dlavila/puc_thesis/lascas/Digital assistance for energy reduction in analogue-to-digital converters using a signal prediction algorithm/bib.bib.tex

@ARTICLE{1624325, 
author={Murmann, B.}, 
journal={Micro, IEEE}, title={Digitally Assisted Analog Circuits}, 
year={2006}, 
volume={26}, 
number={2}, 
pages={38-47}, 
keywords={analogue circuits;analogue-digital conversion;digital-analogue conversion;mixed analogue-digital integrated circuits;analog circuit;analog signal;analog-to-digital converter;digital circuit;digital-to-analog converter;power efficiency;Analog circuits;Analog computers;Broadband antennas;CMOS technology;Computer interfaces;Low-noise amplifiers;Power dissipation;Radio frequency;Sampling methods;Throughput;analog circuits;analog signals;analog-to-digital converter;digital computing}, 
doi={10.1109/MM.2006.33}, 
ISSN={0272-1732},}
