dlavila/puc_thesis/thesis/Chacarero/chacarero.pptx

## Discrete-time noise filtering for Pulse-Processing in particle physics experiments

Diego Ávila

This work was supported by the National Commission for Scientific and Technological Research (CONICYT) of Chile under grant FONDECYT 11110165 and scholarship CONICYT-PCHA/Magíster Nacional/2013 - folio 221320673.

## Outline

1. Motivations
2. Basic concepts: noise analysis for pulse-processing in particle physics experiments
3. Noise analysis in pulse-processing discrete-time filters
4. A SC filter for arbitrary weighting function synthesis (if we have time)
5. Conclusion

## Motivations

- The ILC

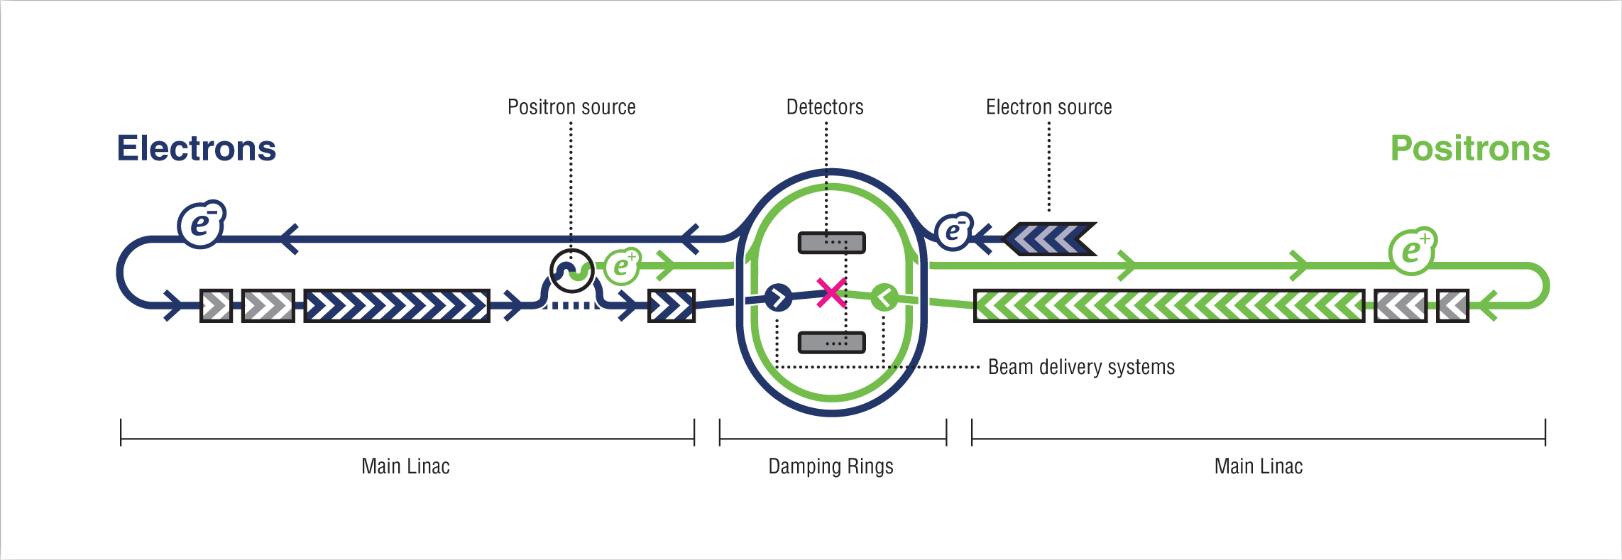
[picture p1: figure]

## Slide 4

- The Bean

## Basic concepts: noise analysis for pulse-processing in particle physics experiments

- As electrical engineers we are used to model the noise in the frequency domain.
- Most of the times we deal with continuous processes: we assume that the noise process started at - ∞ (stationary noise process).

## Slide 6

… but in pulse-processing for particle physics

Start after restarting CF

Finite-time process

End after taking the sample

A continuous-time noise analysis is more intuitive

## Weighting function

- White noise can be modeled as a Poisson sequence of Dirac impulses.
- Colored noise can be modeled as a Poisson sequence of shaped pulses.

## Slide 8

animation

## Slide 9

Our approach

[Avila, Alvarez, Abusleme, IEEE TNS 2013]

## Slide 10

## Slide 11

## Slide 12

## Slide 13

## Slide 14

Result

Low entropy expression: input noise can be easily identified and separate from filter influence

## Slide 15

Comparison (thermal noise)

Weighting function

Our approach

## SNR maximization

- In the following configuration

Where

## Slide 17

we want to minimize

Independent variables

## Slide 18

Results:

## Slide 19

## Slide 20

## A SC filter for arbitrary weighting function synthesis

- UMC180nm (through Europractice)
- Mentor graphics tools (ICUC new analog toolchain)

## Slide 22

## Slide 23

## Slide 24

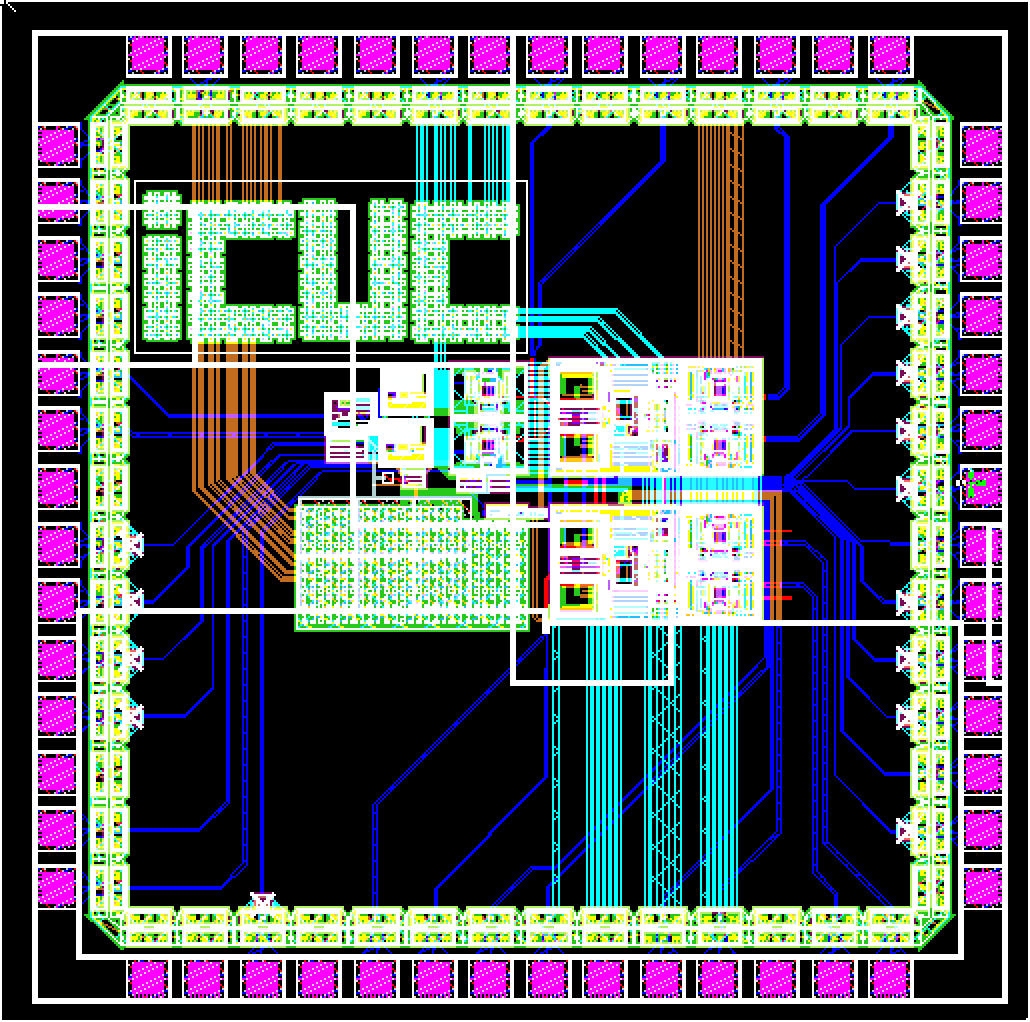
[picture p2: figure]
Screen Shot 2014-04-20 at 8.01.14 PM.pdf

~1.5 mm x 1.5mm

## Slide 25

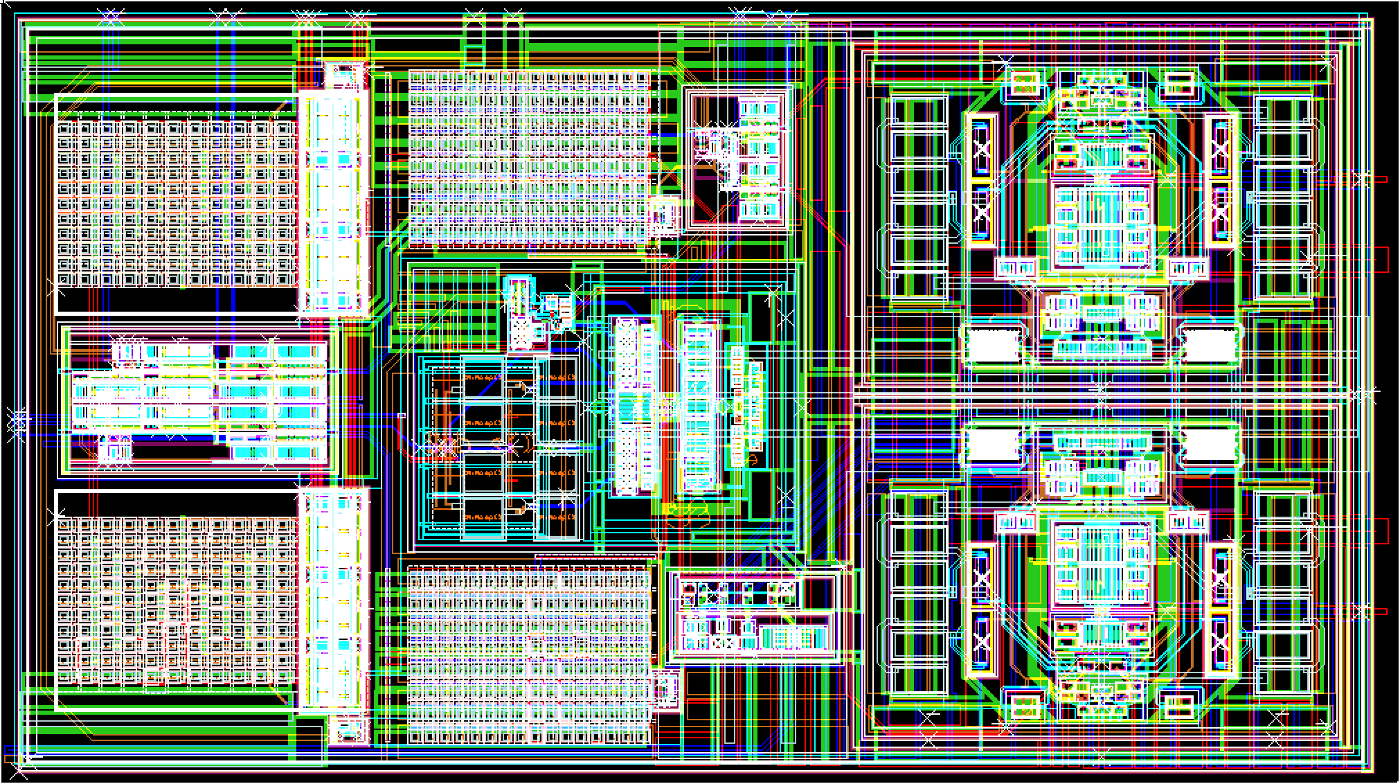
[picture p3: figure]
filter_layout.pdf

Cs Cf OTA Buffers Logic

~ 185um x 332um

## Slide 26

Post-layout simulations

Filter step response (64 available gains)

Due to the binary cap arrangement

## Slide 27

## Slide 28

Conclusion

## Slide 29

Thank you
