dlavila/puc_thesis/Presentation1.pptx

## Discrete-time noise filtering for Pulse-Processing in particle physics experiments

Diego Ávila

This work was supported by the National Commission for Scientific and Technological Research (CONICYT) of Chile under grant FONDECYT 11110165 and scholarship CONICYT-PCHA/Magíster Nacional/2013 - folio 221320673.

## Outline

1. Motivations
2. Basic concepts: noise analysis for pulse-processing in particle physics experiments
3. Noise analysis in pulse-processing discrete-time filters
4. A SC filter for arbitrary weighting function synthesis (if we have time)
5. Conclusion

## Motivations

- The ILC
- The Bean

## Basic concepts: noise analysis for pulse-processing in particle physics experiments

- As electrical engineers we are used to model the noise in the frequency domain.
- Most of the times we deal with continuous processes: we assume that the noise process started at - ∞ (stationary noise process).

## Slide 5

… but in pulse-processing for particle physics

Start after restarting CF

Finite-time process

End after taking the sample

A continuous-time noise analysis is more intuitive

## Weighting function

- White noise can be modeled as a Poisson sequence of Dirac impulses.
FALTA COMPLETAR

## Slide 7

Our approach

## Slide 8

## Slide 9

## Slide 10

## Slide 11

## Slide 12

Result

Low entropy expression: input noise can be easily identified and separate from filter influence

## SNR maximization

- In the following configuration

Where

## Slide 14

we want to minimize

Independent variables

## Slide 15

Results:

## Slide 16

## Slide 17

## A SC filter for arbitrary weighting function synthesis

- UMC180nm (through Europractice)
- Mentor graphics tools (ICUC new analog toolchain)

## Slide 19

Screen Shot 2014-04-20 at 8.01.14 PM.pdf

~1.5 mm x 1.5mm

## Slide 20

filter_layout.pdf

Cs Cf OTA Buffers Logic

~ 185um x 332um

## Slide 21

Post-layout simulations

Filter step response (64 available gains)

Due to the binary cap arrangement

## Slide 22

FALTA LA FIGURA DEL STEP RESPONSE CON TIEMPO DE ESTABLECIMIENTO
FALTA LA FIGURA EN QUE SE VERIFICAN HOLD, RST, SGN
