dlavila/puc_thesis/thesis/figures/thebean_diag-eps-converted-to.pdf

# The Bean Prototype

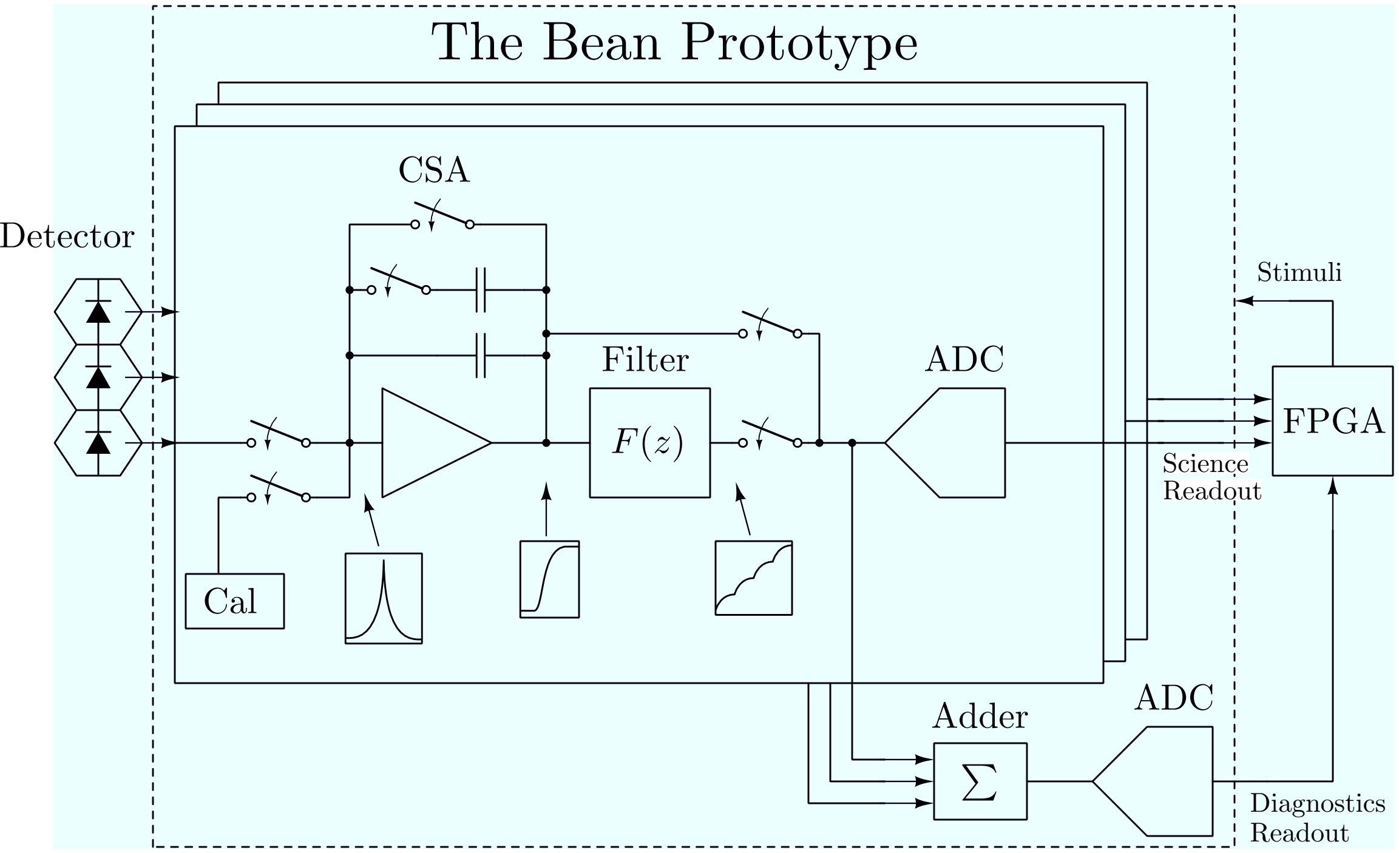
[picture p4: page 1]

Detector

CSA

Filter | ADC

ADC Adder

FPGA

!

F(z)

Cal

Diagnostics
Readout

Stimuli

Science
Readout
