dlavila/puc_thesis/thesis/figures/noise_cir-eps-converted-to.pdf

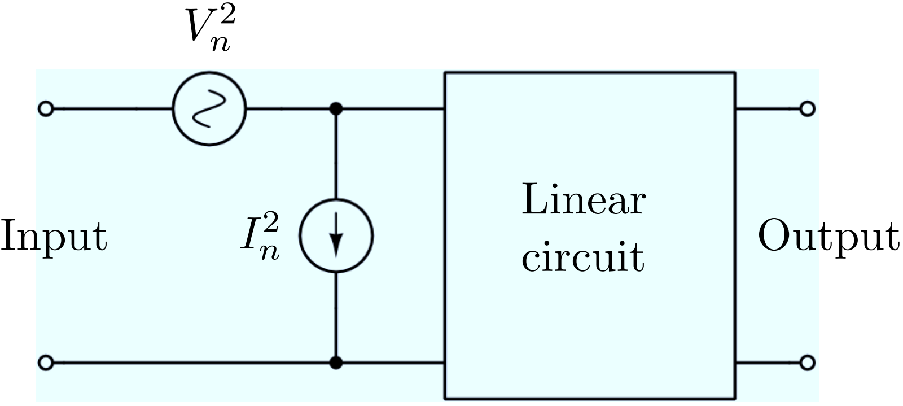
[picture p5: page 1]

Linear

circuit

V

2n

I

2

## Input

n | Output
