dlavila/puc_thesis/thesis/figures/filter_layout.pdf

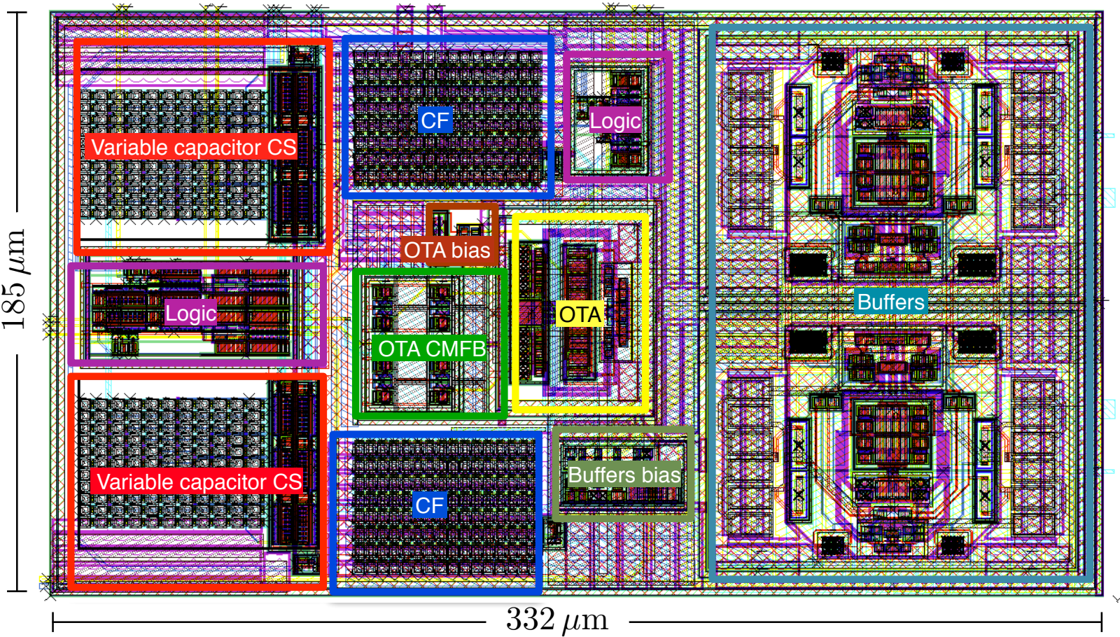
[picture p6: page 1]

332 µm

185

µ

m

OTA CMFB

OTA

CF

CF

Variable capacitor CS

Variable capacitor CS

Buffers Logic

OTA bias

Logic

Buffers bias
