dlavila/puc_thesis/thesis/figures/IC_layout.pdf

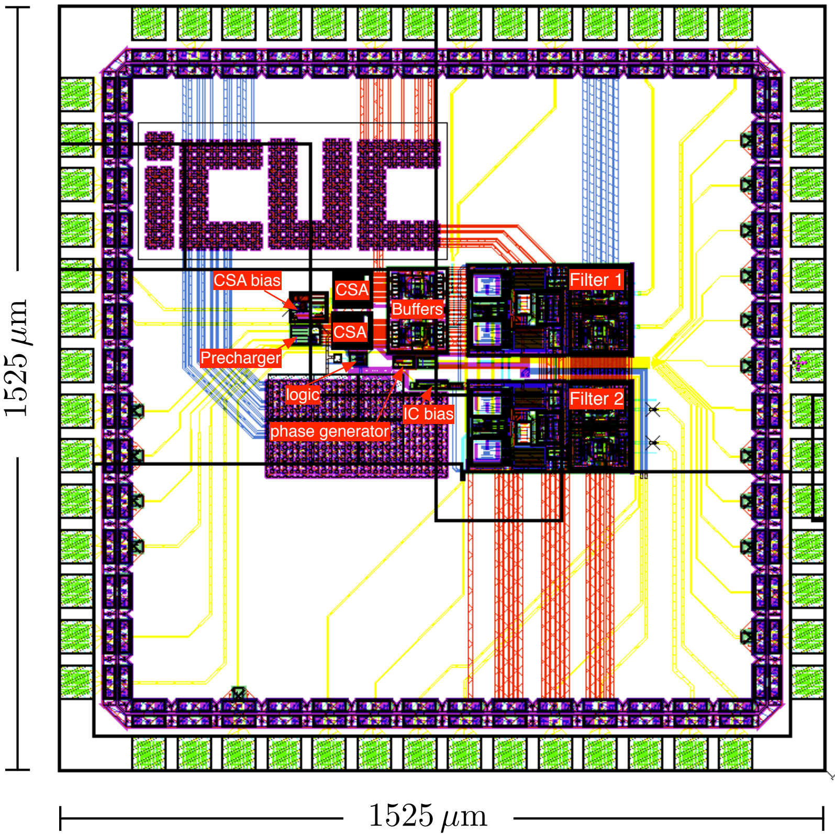
[picture p7: page 1]

1525 µm

1525

µ

m

Filter 1

Filter 2

Buffers
CSA

CSA

IC bias

Precharger

phase generator

CSA bias

logic
