dlavila/puc_thesis/thesis/figures/Filter/bias_filter_post-eps-converted-to.pdf

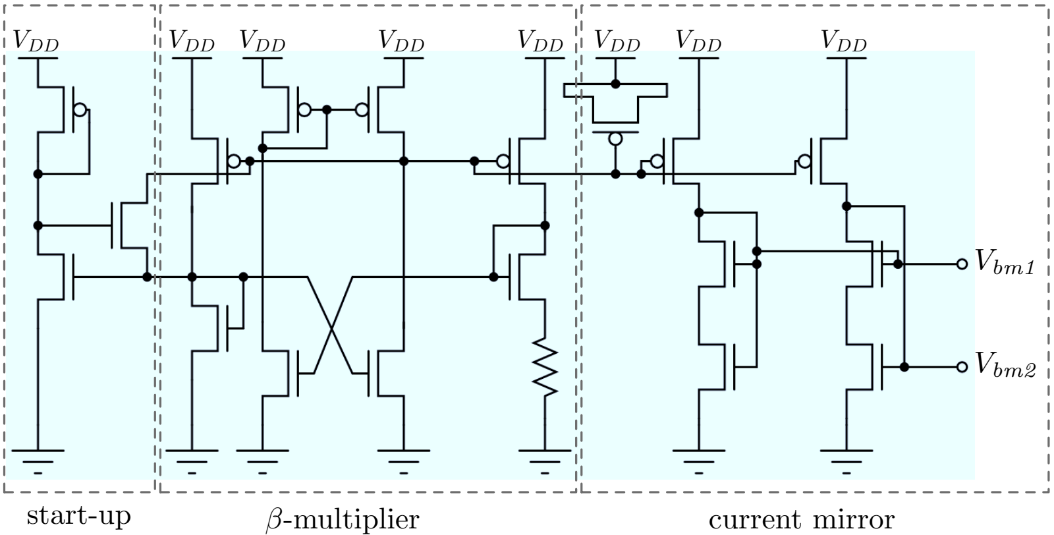
[picture p8: page 1]

VDD | VDD | VDD | VDD | VDD | VDD | VDD | VDD

Vbm1

Vbm2

start-up | β-multiplier | current mirror
