dlavila/puc_thesis/thesis/figures/bondpad.pdf

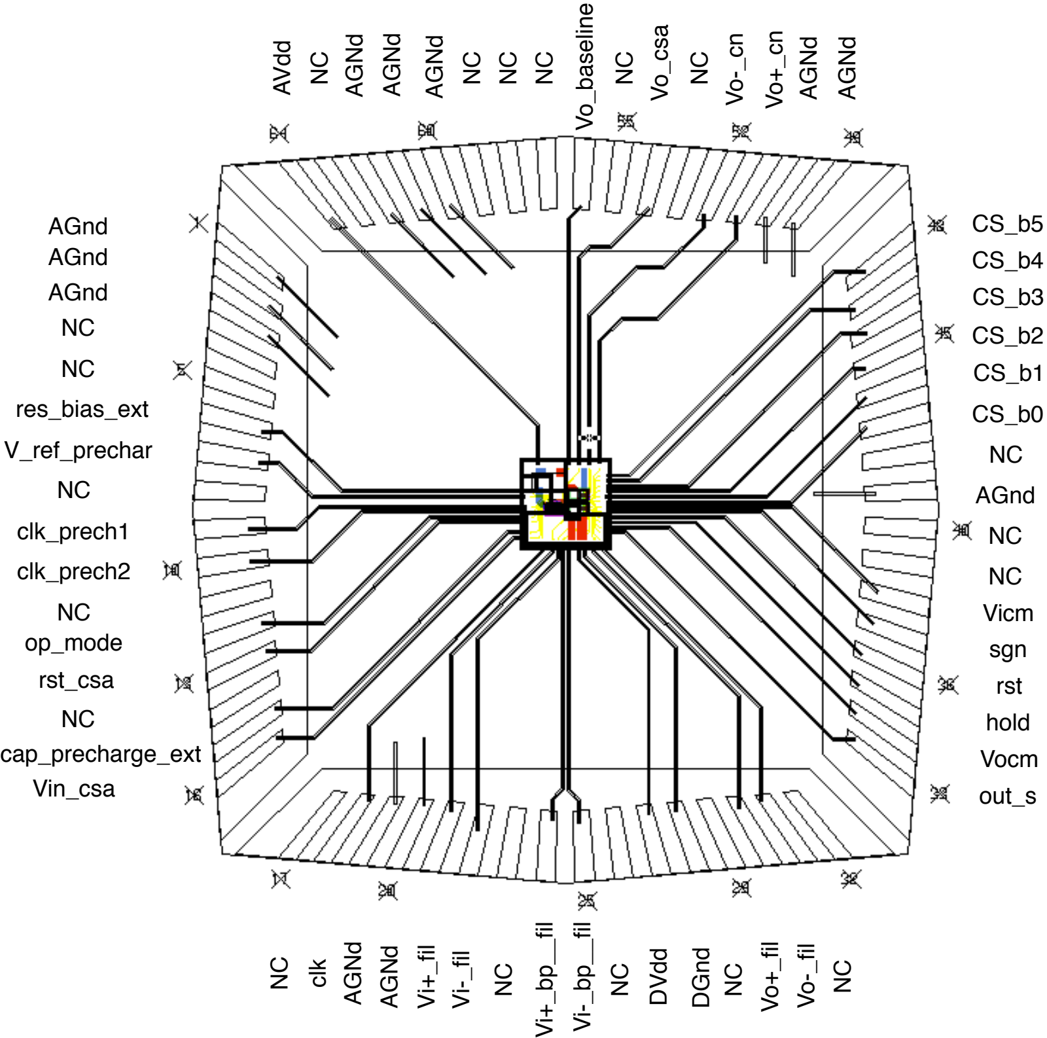
[picture p9: page 1]

AGnd
AGnd
AGnd
NC
NC
res_bias_ext

NC

clk_prech1
clk_prech2

NC
op_mode
rst_csa
NC
cap_precharge_ext
Vin_csa

V_ref_prechar

NC
clk

AGNd
AGNd

Vi+_fil
Vi-_fil
NC

Vi+_bp__fil
Vi-_bp__fil

NC

DVdd

DGnd
NC

Vo+_fil
Vo-_fil
NC

out_s

Vocm

hold

rst

sgn

Vicm

NC

NC

AGnd

NC

CS_b0

CS_b1

CS_b2

CS_b3

CS_b4

CS_b5

NC

NC

NC

NC

NC

NC

AGNd

AGNd

Vo_csa
Vo-_cn

Vo+_cn

Vo_baseline
AVdd

AGNd

AGNd
AGNd
