dlavila/puc_thesis/thesis/figures/buffer_layout-eps-converted-to.pdf

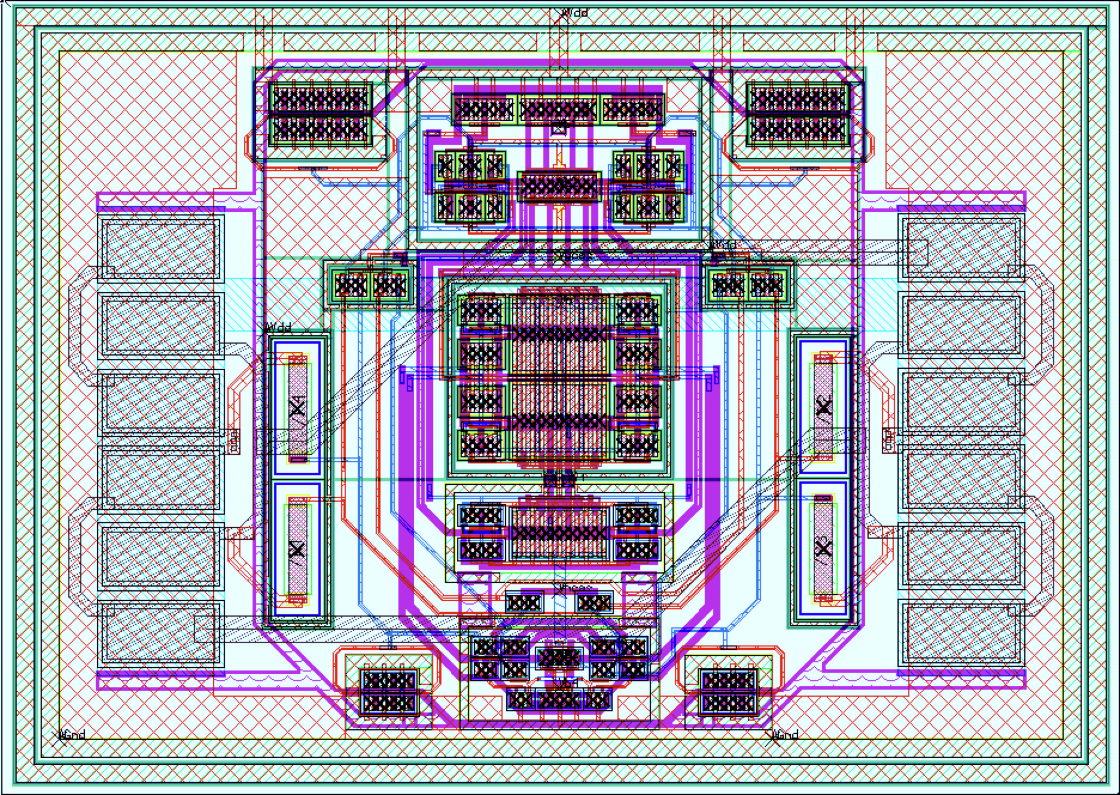
[picture p10: page 1]
