dlavila/puc_thesis/thesis/figures/CSA_layout-eps-converted-to.pdf

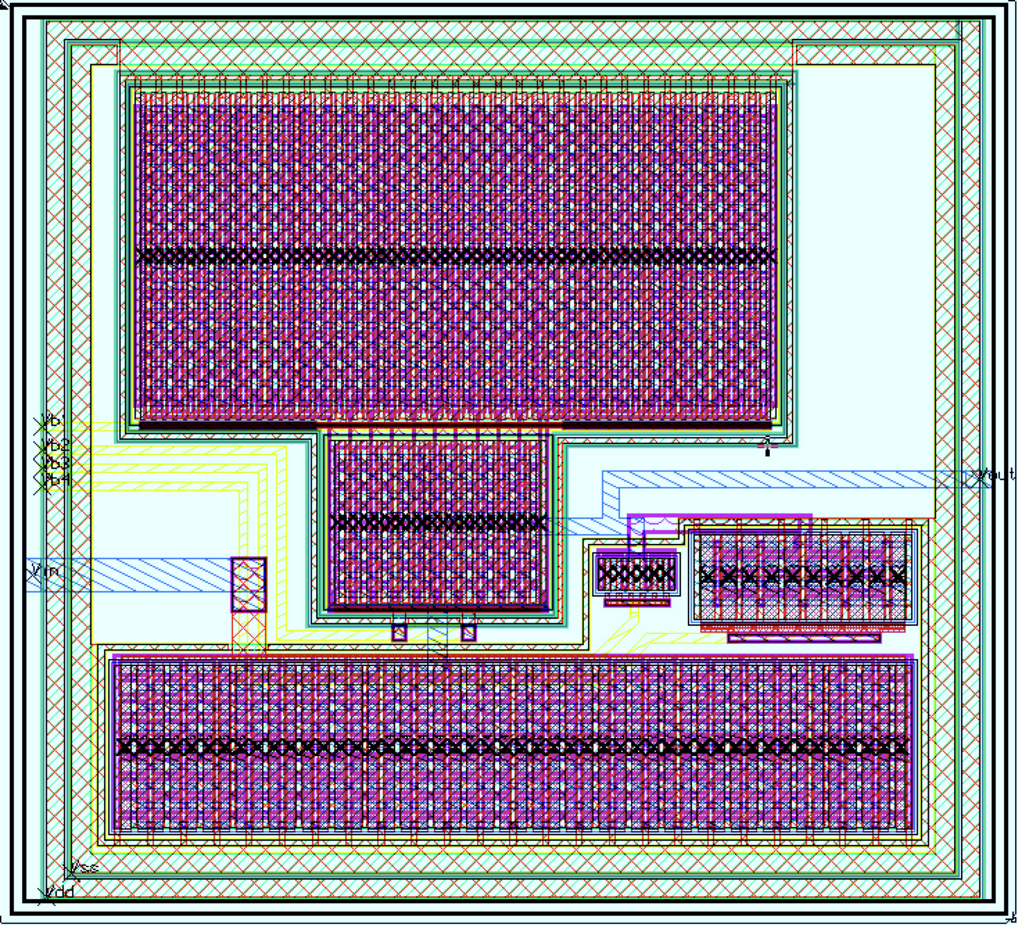
[picture p11: page 1]
