dlavila/puc_thesis/thesis/figures/csa_post-eps-converted-to.pdf

C

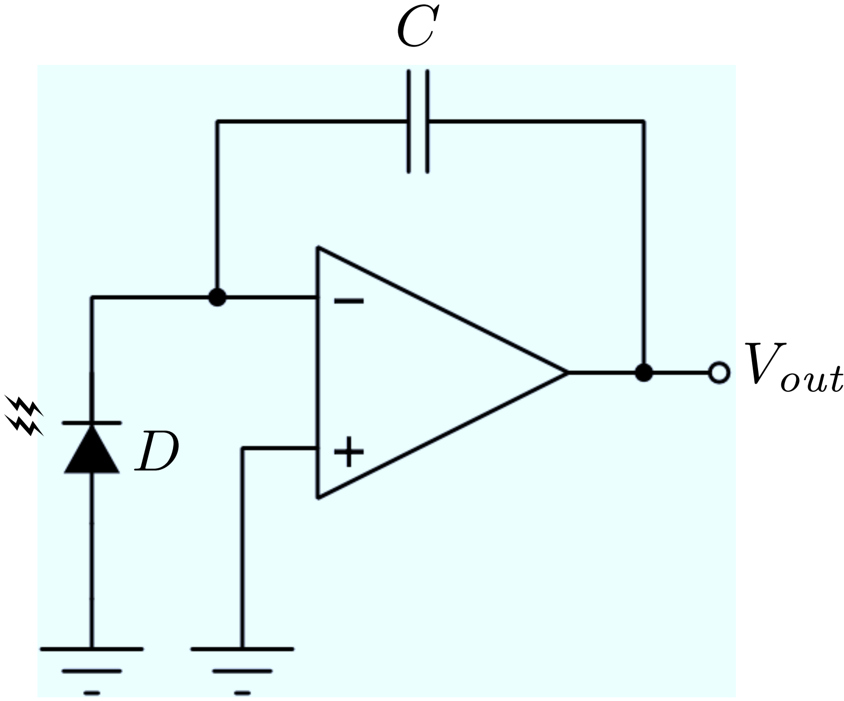
[picture p12: page 1]

D

Vout
