dlavila/puc_thesis/thesis/figures/OTA_layout-eps-converted-to.pdf

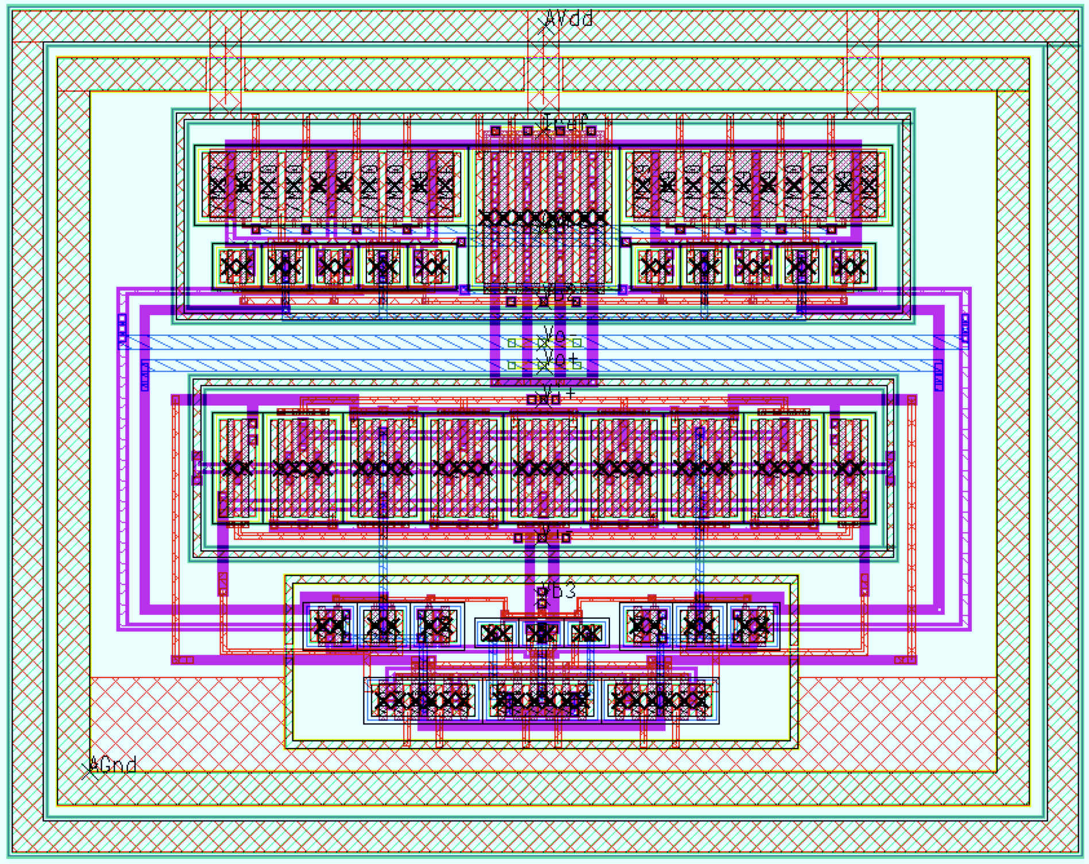
[picture p13: page 1]
