dlavila/puc_thesis/thesis/figures/Untitled.graffle/image1.pdf

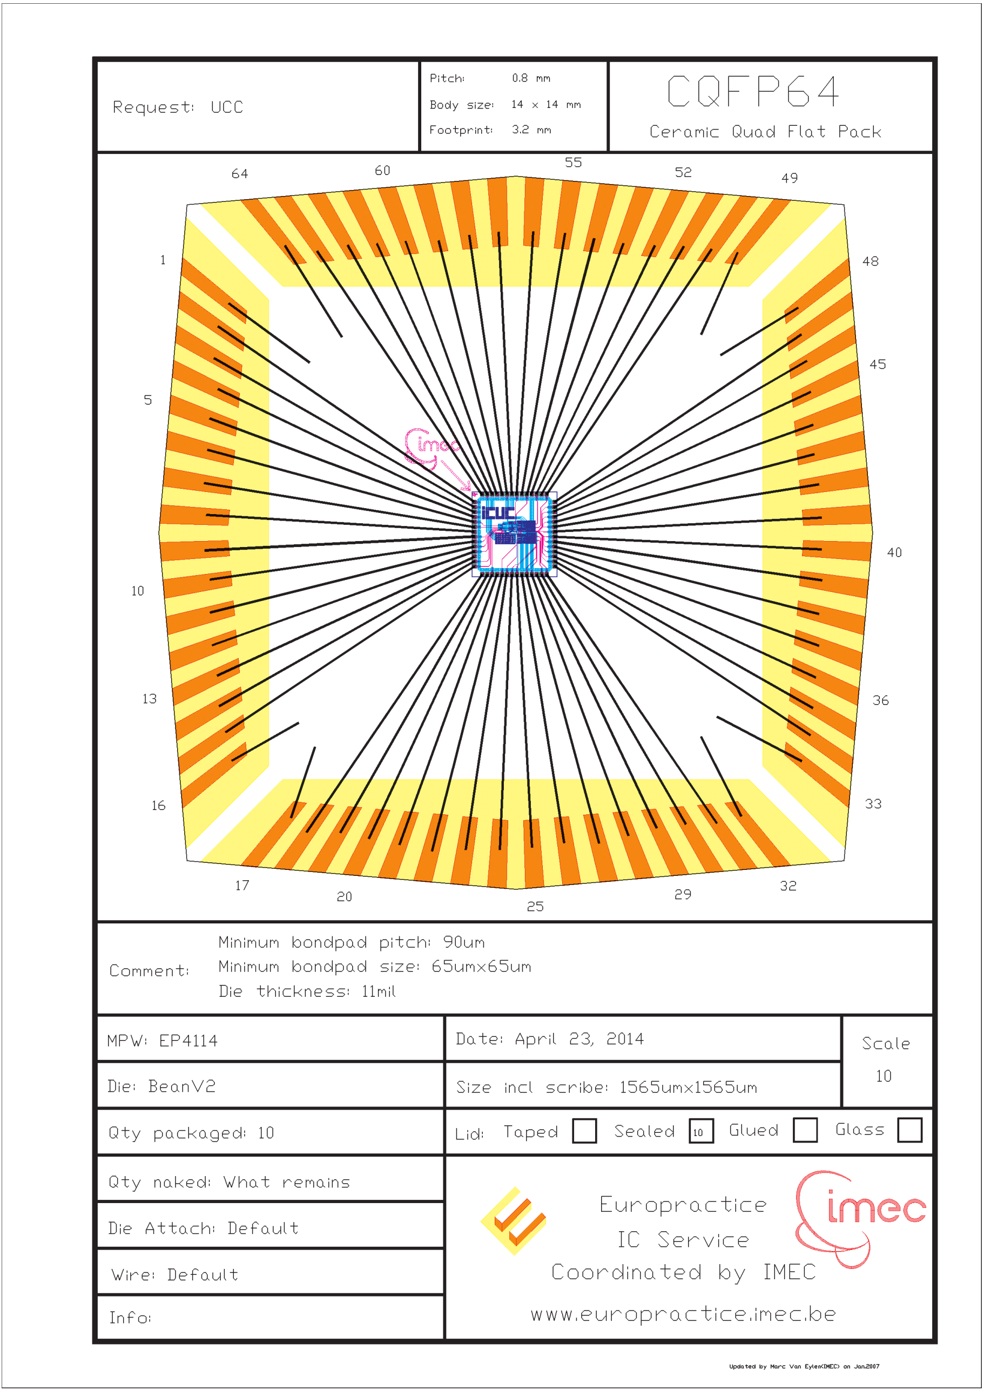
[picture p14: page 1]
