dlavila/puc_thesis/thesis/figures/Filter/bias_all_post-eps-converted-to.pdf

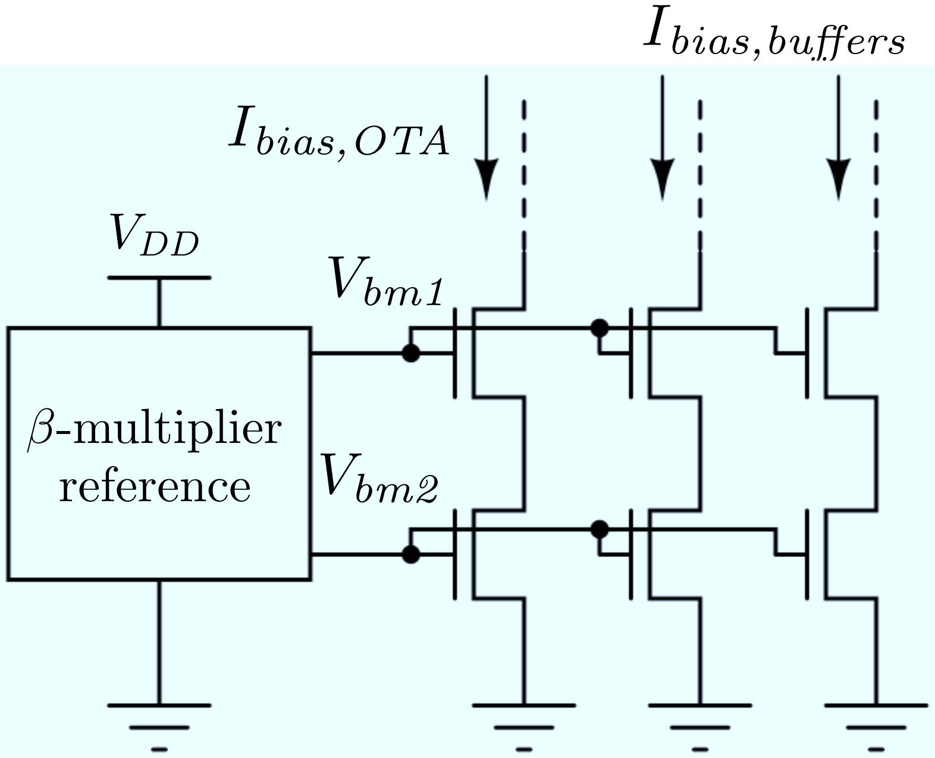
[picture p15: page 1]

VDD

### β-multiplier

reference

Ibias,OTA

Ibias,buffers

Vbm1

Vbm2
