dlavila/puc_thesis/thesis/figures/Filter/bias_buffer_post-eps-converted-to.pdf

Vb1

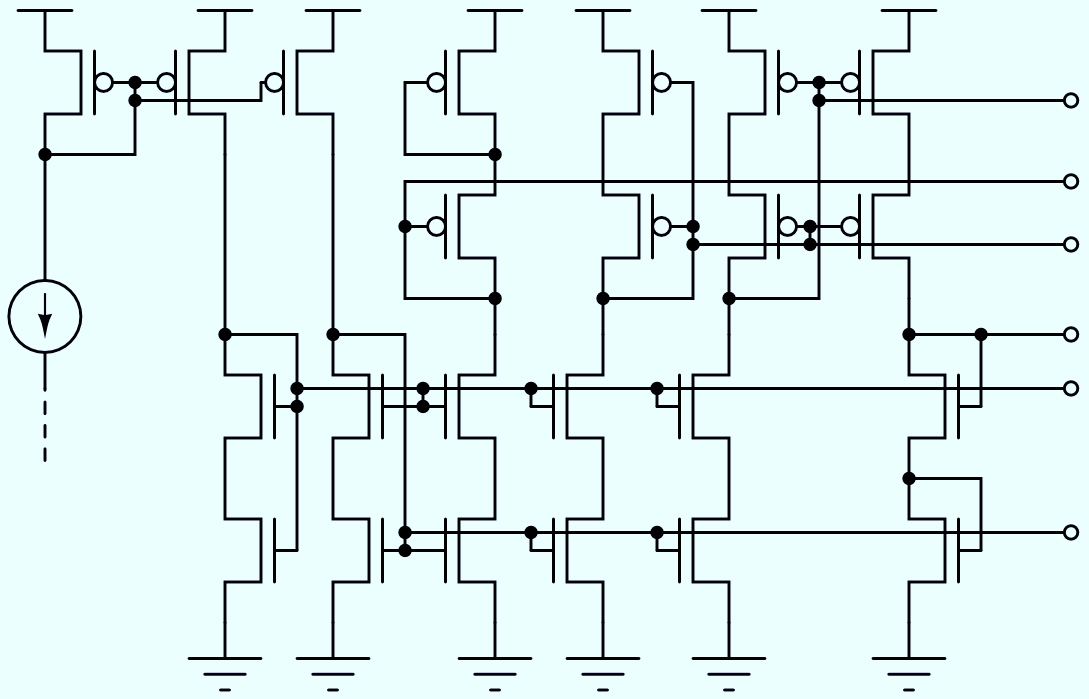
[picture p16: page 1]

VDD | VDD | VDD | VDD | VDD | VDD | VDD

## Ibias,buffer

Vpcas

Vncas

Vb2

Vb3

Vb4
