dlavila/puc_thesis/lascas/Digital assistance for energy reduction in analogue-to-digital converters using a signal prediction algorithm/Figures/graph.png

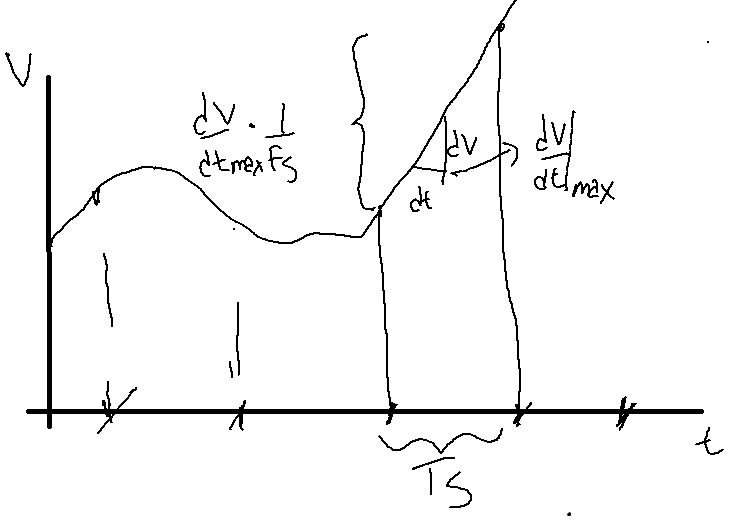
lascas/Digital assistance for energy reduction in analogue-to-digital converters using a signal prediction algorithm/Figures/graph.png
