dlavila/puc_thesis/(list of files, cad)

Other CAD files:
sc_ic/giggity.proj/SC_filter.lib/default.group/layout.views/BUFFER/BUFFER.cal/svdb/template/BUFFER.stl
sc_ic/giggity.proj/SC_filter.lib/default.group/layout.views/BUFFER/BUFFER_2.cal/svdb/template/BUFFER_2.stl
