dlavila/puc_thesis/thesis/Test/test_gains_step_response.csv

.HEADER
..NAMES
Time | V(VO)
..UNITS
s | Voltage(V)
..DATATYPES
double | double
..WAVEFORM_TYPES
 | analog
..AXIS_SPACING
linear
..RUN_FOLDER_INDEX
_1
..FOLDER_NAME
CHANNEL_DesignConfig_test_gains | TRAN
.DATA
5.000000000000001E-8 | 9.227663443860028E-6
5.000125000000001E-8 | 9.16002651162706E-6
5.00023583193436E-8 | 9.082836007867893E-6
5.000457495803077E-8 | 8.91100003973886E-6
5.0008420135110545E-8 | 8.66966003073739E-6
5.001E-8 | 8.650704488284232E-6
5.0011525132285446E-8 | 8.776080441715875E-6
5.001274936410694E-8 | 8.920867765143809E-6
5.0015197827749926E-8 | 9.281286576096154E-6
5.00200947550359E-8 | 1.0274120710818745E-5
5.002983483796483E-8 | 1.2472272408177596E-5
5.003701806581601E-8 | 1.3907320104834784E-5
5.0043845768705344E-8 | 1.49749821532747E-5
5.00533131533761E-8 | 1.5925062258693475E-5
5.006446712603446E-8 | 1.5907476675892455E-5
5.0078742711033945E-8 | 1.3069390876949853E-5
5.010289107645996E-8 | -2.1990954497308337E-6
5.011841843115221E-8 | -2.248029835547154E-5
5.013176936053118E-8 | -5.297205088264788E-5
5.014683145379578E-8 | -1.0064615647388292E-4
5.01610422010588E-8 | -1.4142333546172682E-4
5.0173114820718617E-8 | -1.5727134090557477E-4
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
