dlavila/puc_thesis/thesis/Test/wf_test_circuit-eps-converted-to.pdf

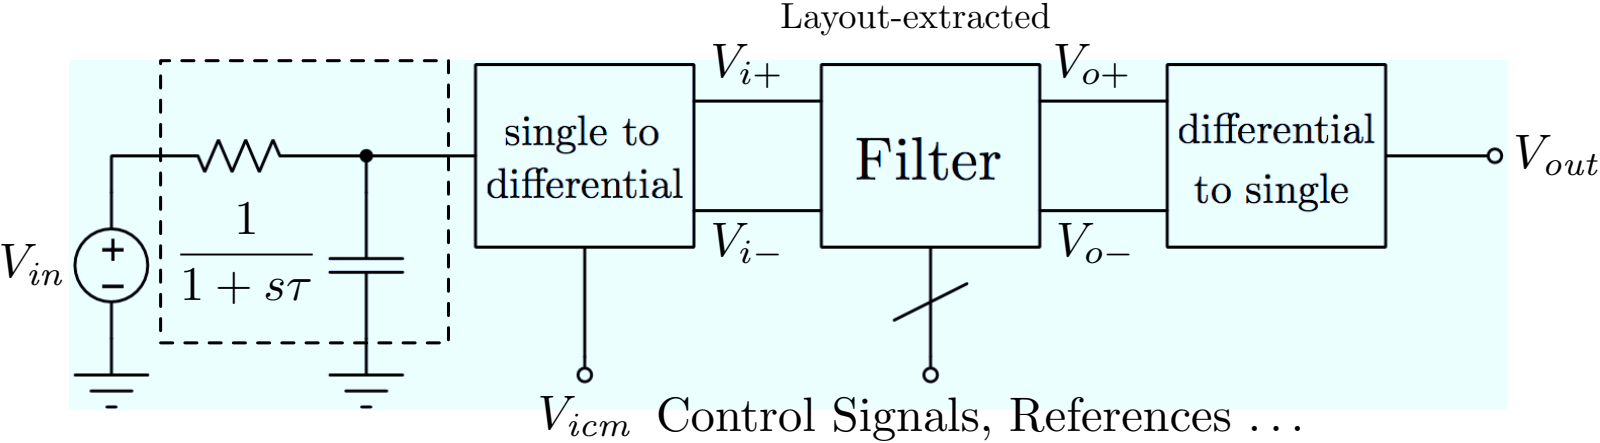
[picture p21: page 1]

Layout-extracted

Filter single to
differential

differential
to single

Vin

Vout

Vicm Control Signals, References . . .

Vi+

Vi− | Vo− Vo+

1

1 + sτ
