dlavila/puc_thesis/thesis/Test/bode_buffer.pdf

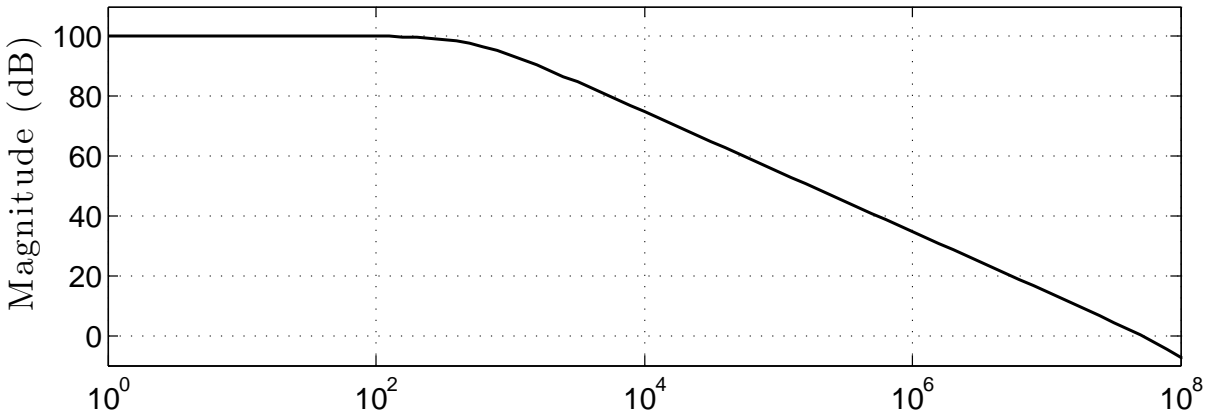
[picture p22: figure]
Magnitude (dB)
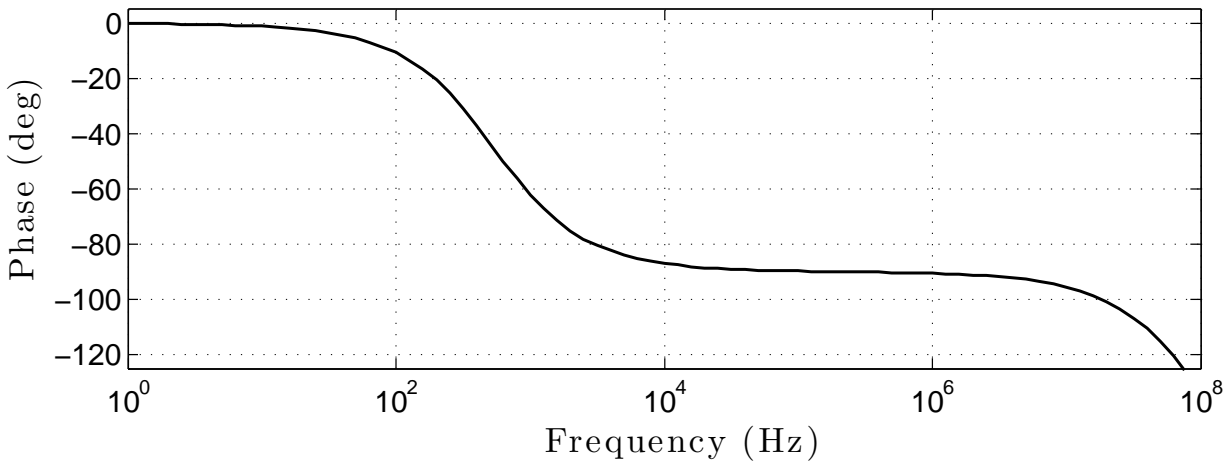
[picture p23: figure]
Phase (de g); Frequency (Hz )
