dlavila/puc_thesis/thesis/Test/bode_OTA.pdf

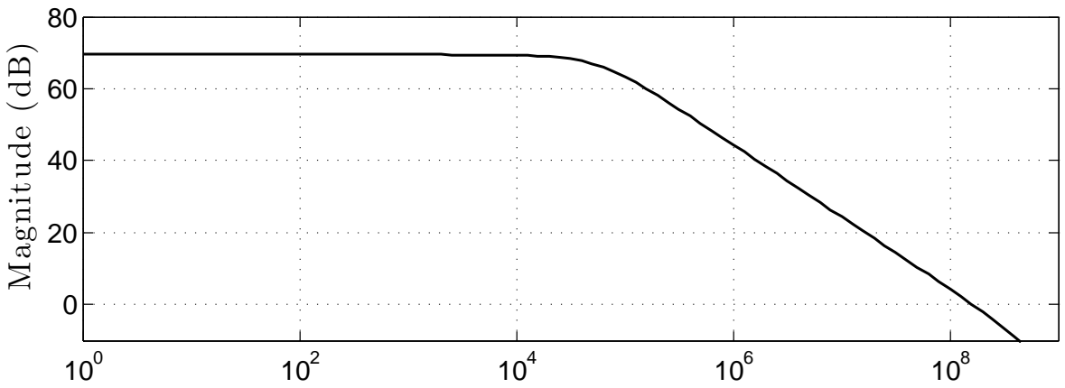
[picture p24: figure]
Magnitude (dB)
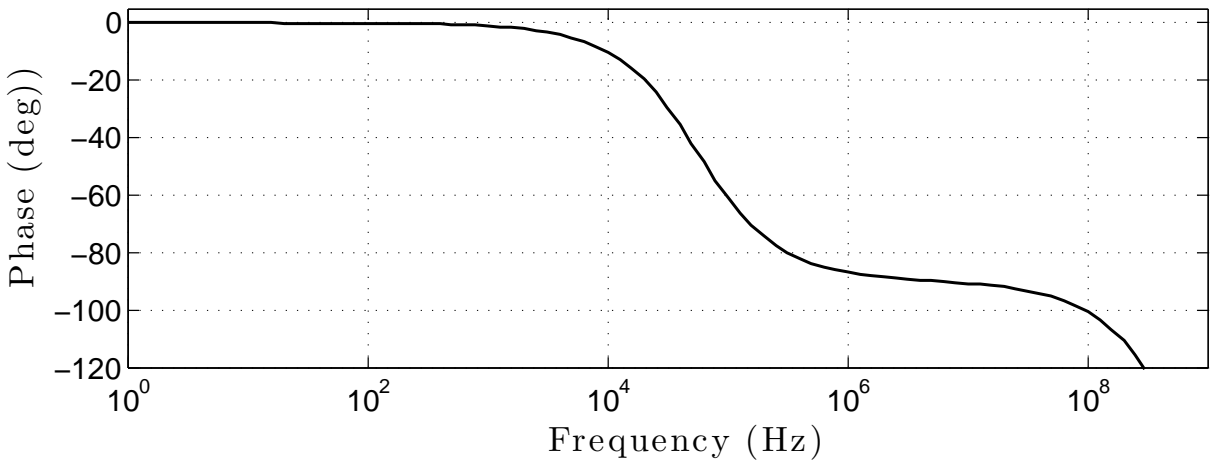
[picture p25: figure]
Phase (de g)); Frequency (Hz )
