dlavila/puc_thesis/thesis/Test/Untitled.graffle/image1.png

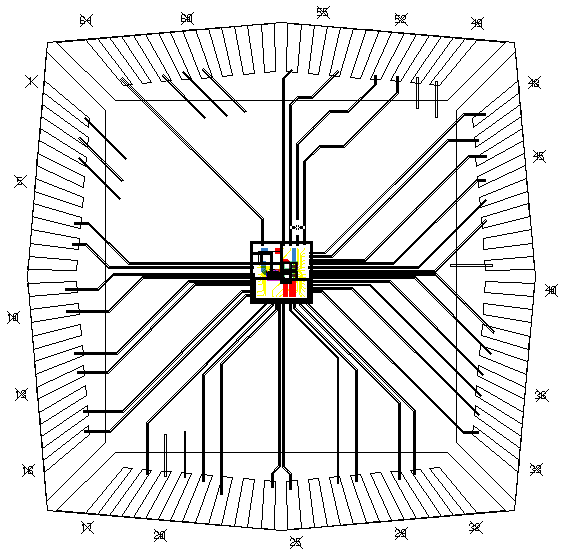
thesis/Test/Untitled.graffle/image1.png
