dlavila/puc_thesis/thesis/Test/Untitled.graffle/image2.png

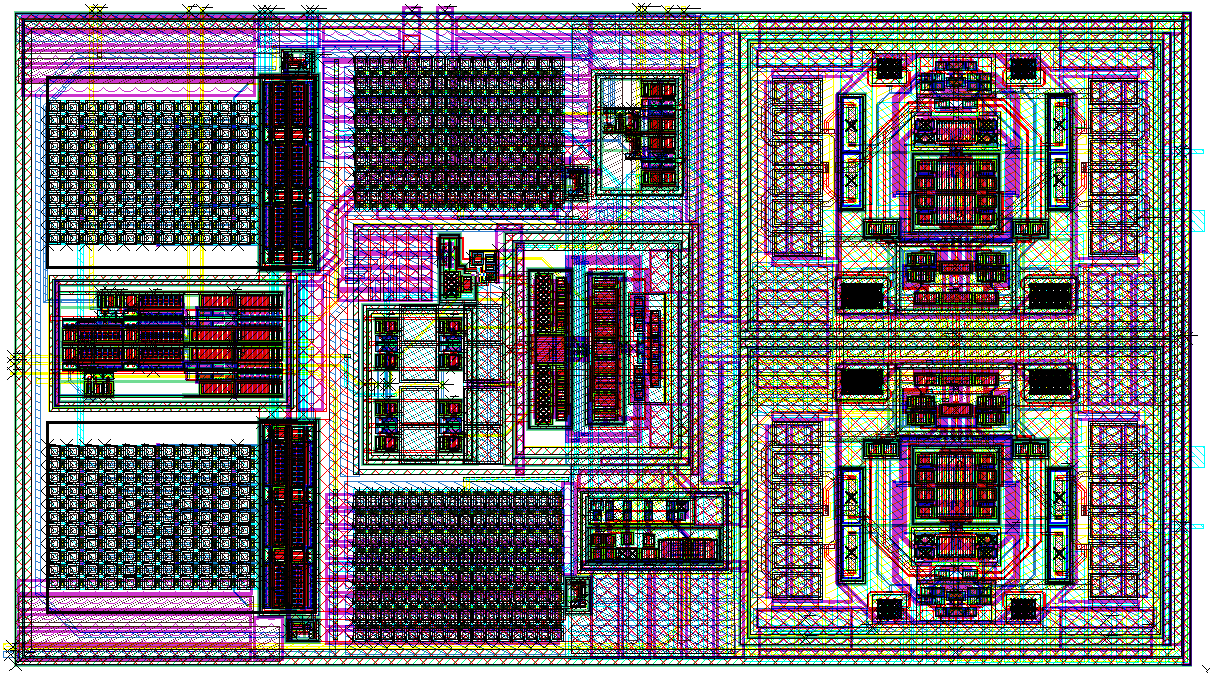
thesis/Test/Untitled.graffle/image2.png
