dlavila/puc_thesis/thesis/Test/Untitled.graffle/image3.png

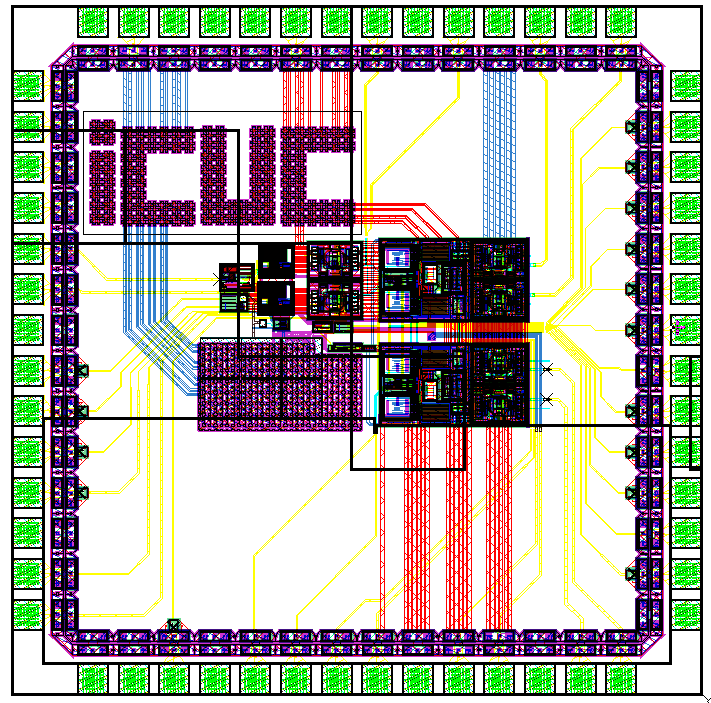
thesis/Test/Untitled.graffle/image3.png
