dlavila/puc_thesis/thesis/Test/bode_buffer_post.pdf

# Frequency (Hz)ADC = 100

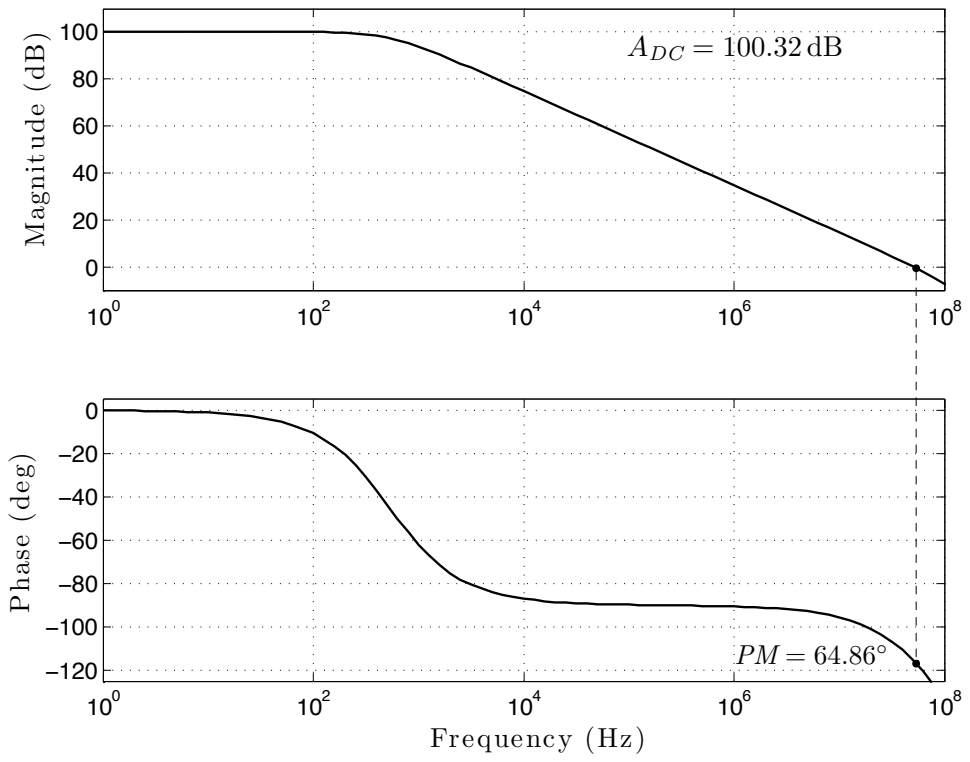
[picture p29: page 1]
Magnitude (dB); Phase (deg)
