dlavila/puc_thesis/thesis/Test/bode_OTA_post-eps-converted-to.pdf

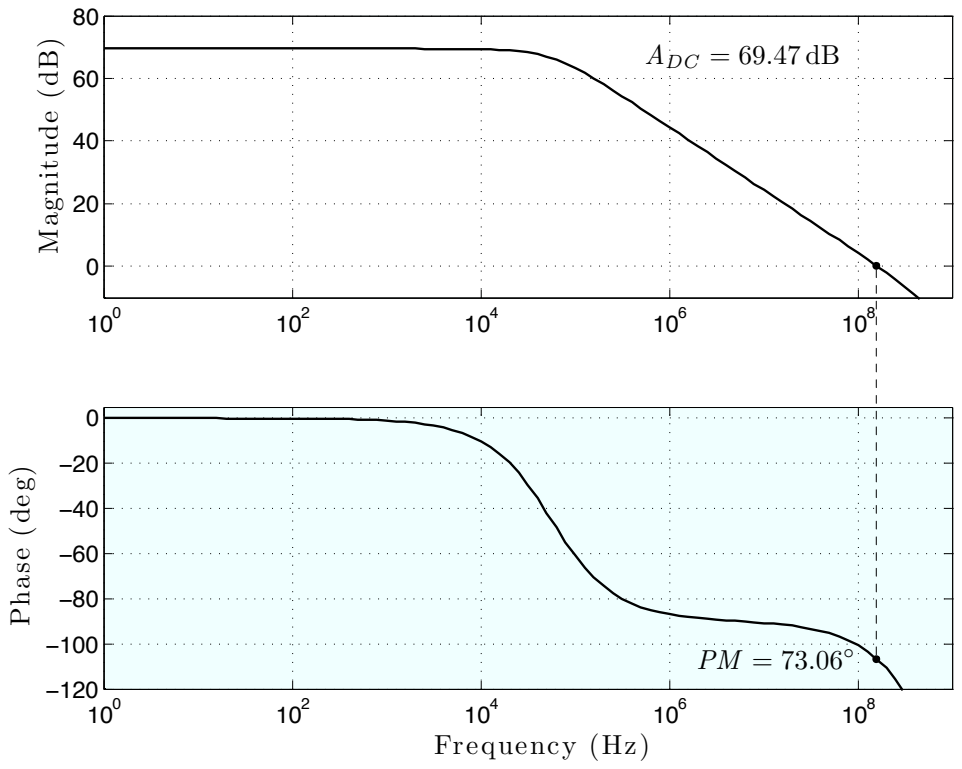
[picture p30: page 1]
Magnitude (dB); Phase (de g)); Frequency (Hz ); ADC = 69 .47 dB
