dlavila/puc_thesis/thesis/Test/gain_curves-eps-converted-to.pdf

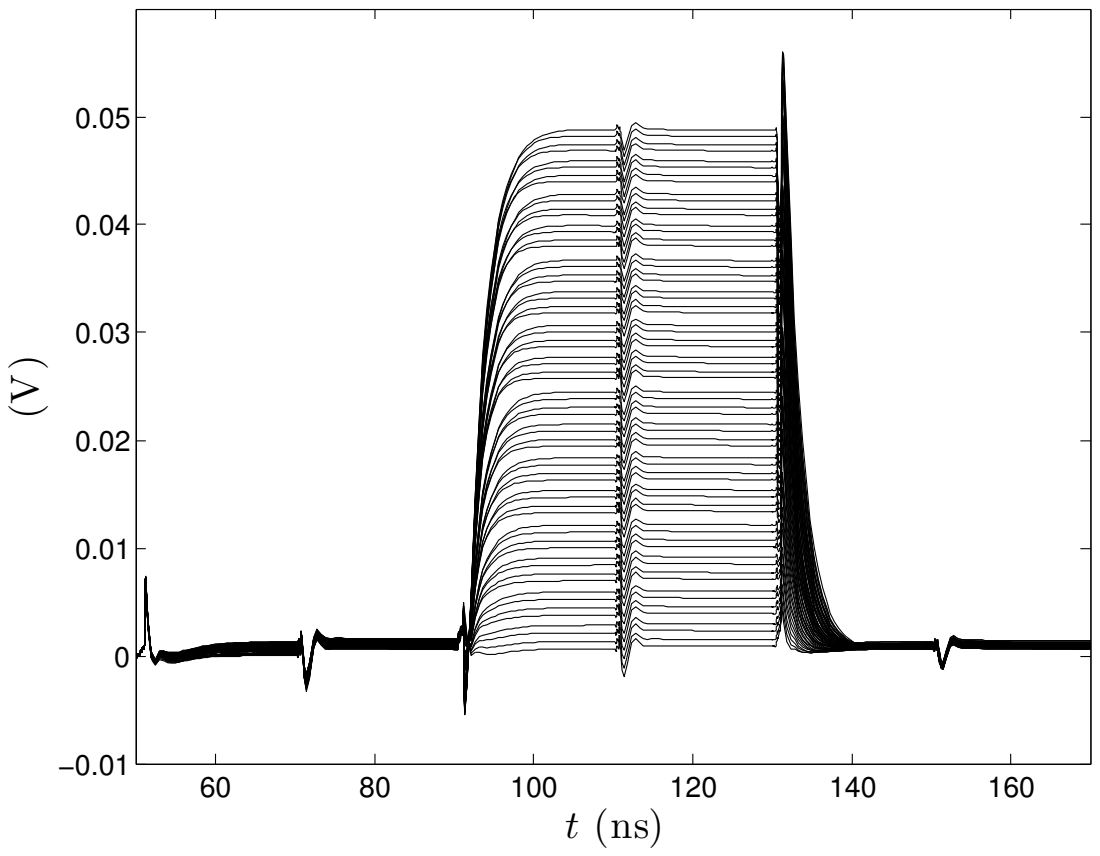
[picture p31: page 1]
