dlavila/puc_thesis/thesis/Test/gain_curves.pdf

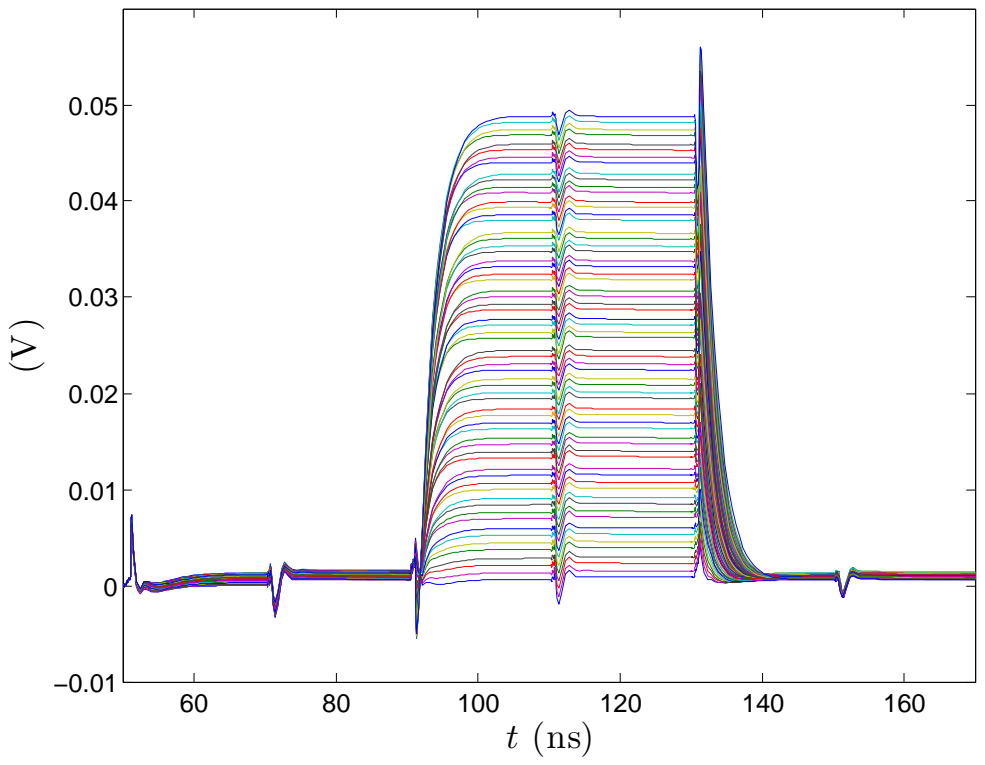
[picture p32: page 1]
