dlavila/puc_thesis/thesis/Test/linearity.pdf

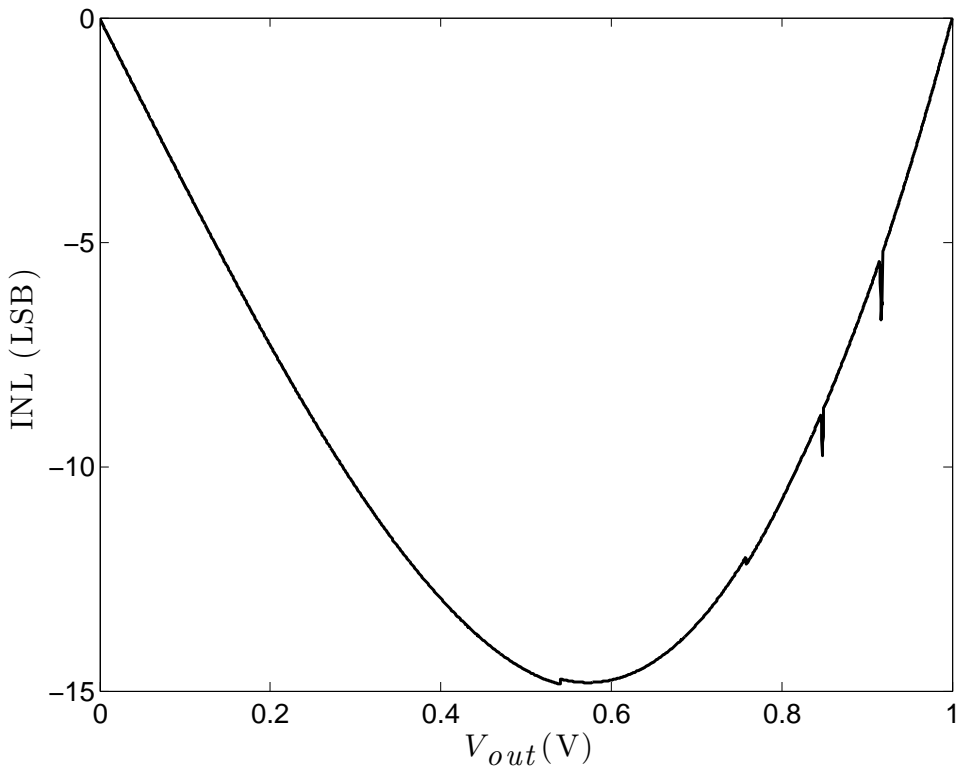
[picture p33: page 1]
INL (LSB ); Vout (V)
