dlavila/puc_thesis/thesis/Test/settling_time.pdf

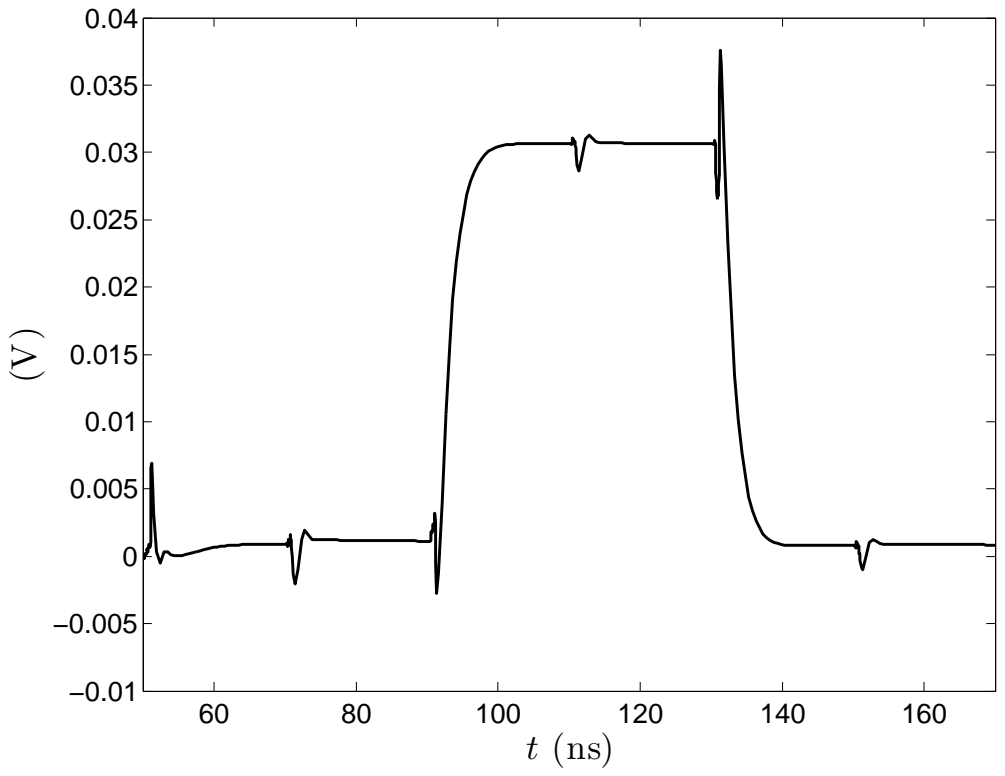
[picture p34: page 1]
