dlavila/puc_thesis/thesis/Test/sim_wf-eps-converted-to.pdf

0.81

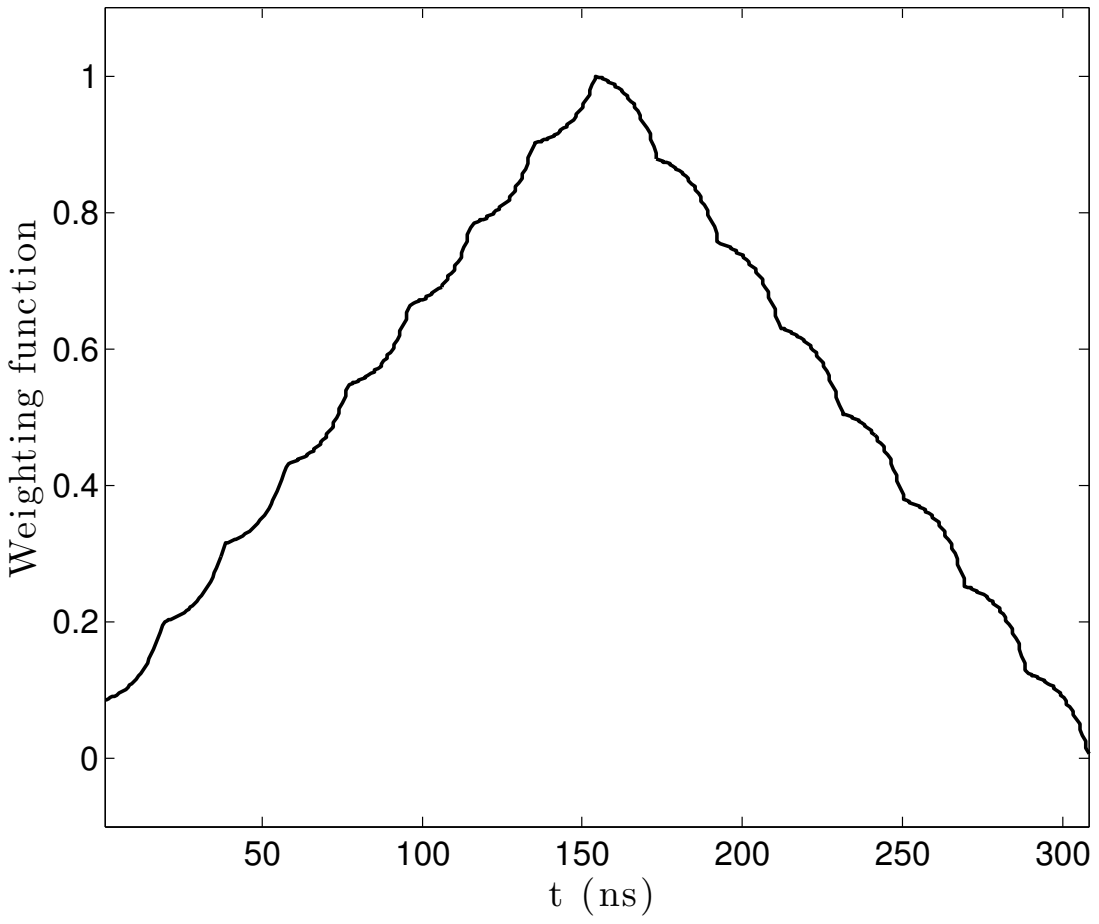
[picture p35: page 1]
Weighting function
