dlavila/puc_thesis/thesis/Test/sim_wf.pdf

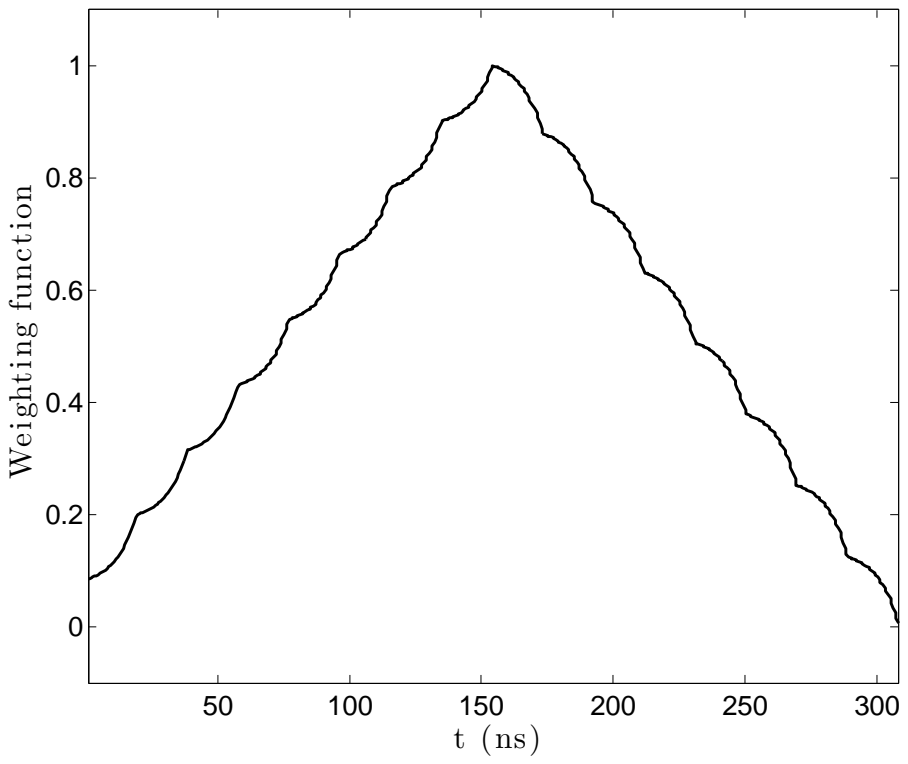
[picture p36: page 1]
Weighting function
