dlavila/puc_thesis/thesis/Test/test_filter.pdf

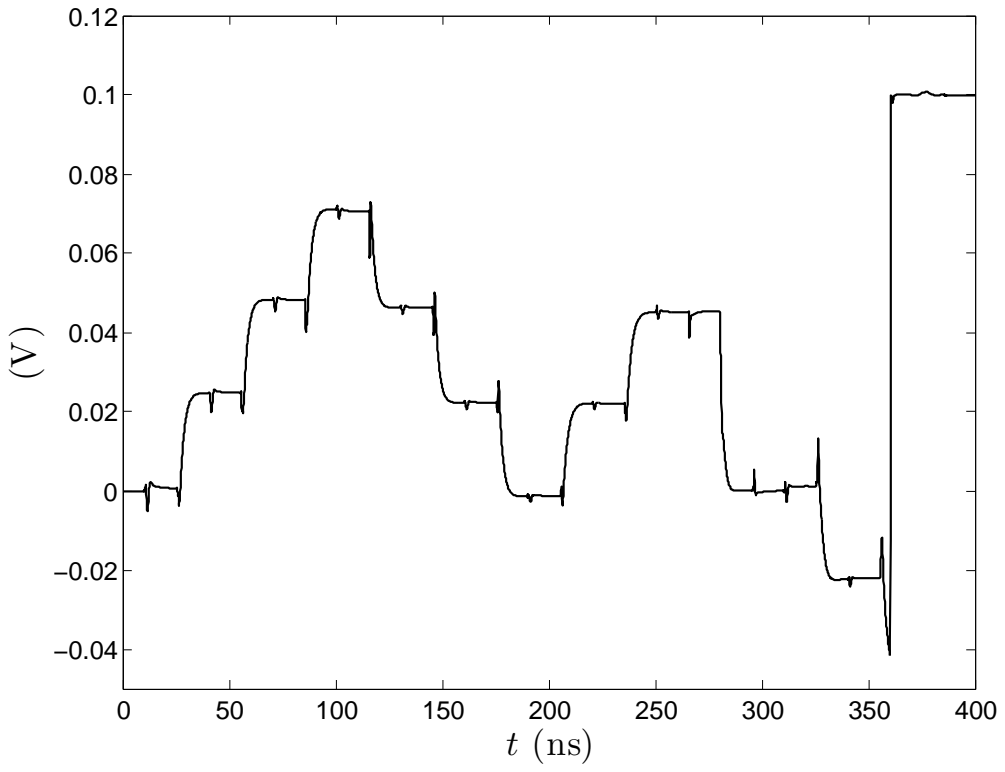
[picture p37: page 1]
