dlavila/puc_thesis/thesis/Test/test_filter_after_omni-eps-converted-to.pdf

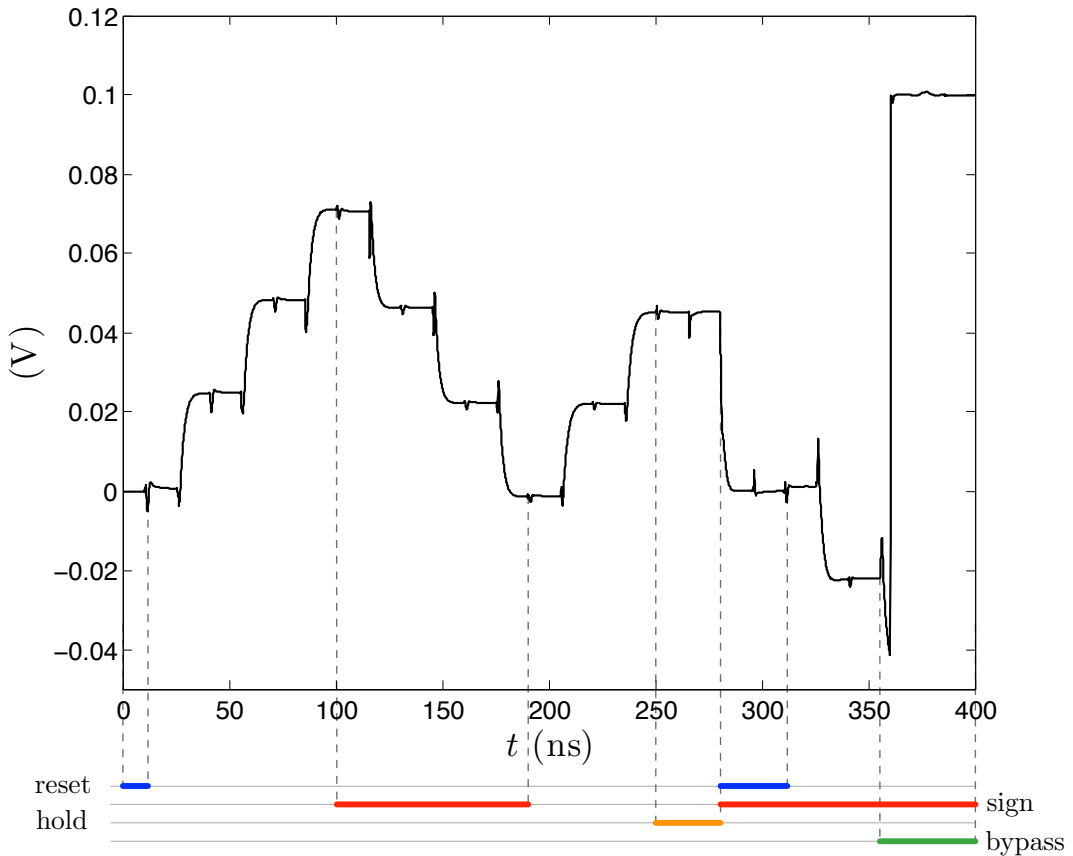
[picture p38: page 1]
reset; sign hold; bypass
