dlavila/puc_thesis/thesis/figures/envelope-example-eps-converted-to.pdf

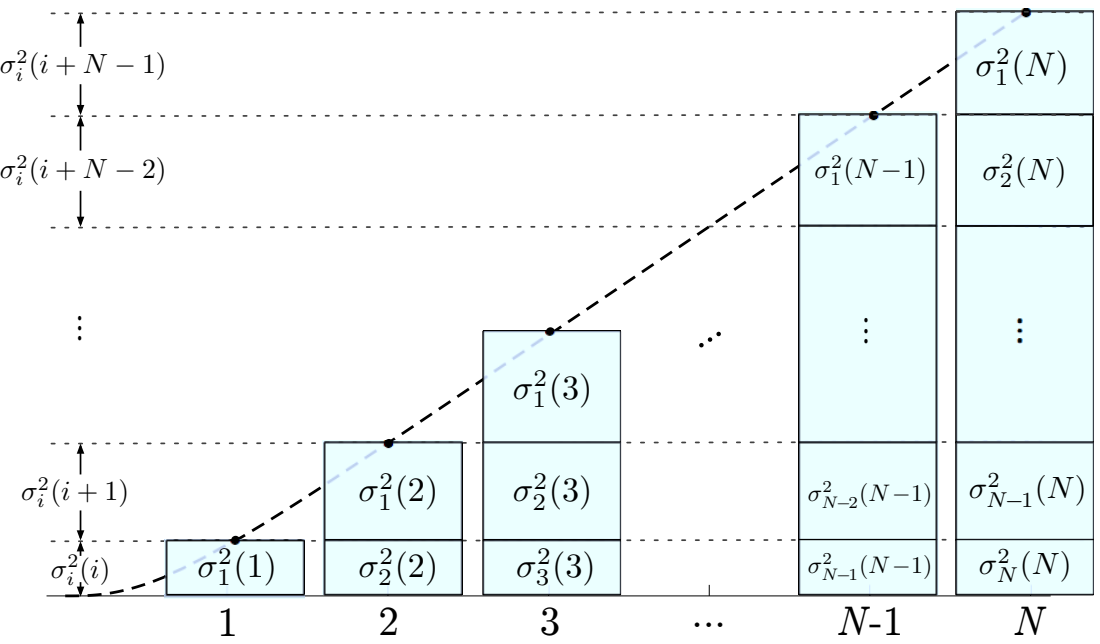
[picture p39: page 1]
