dlavila/puc_thesis/thesis/figures/envelopes-eps-converted-to.pdf

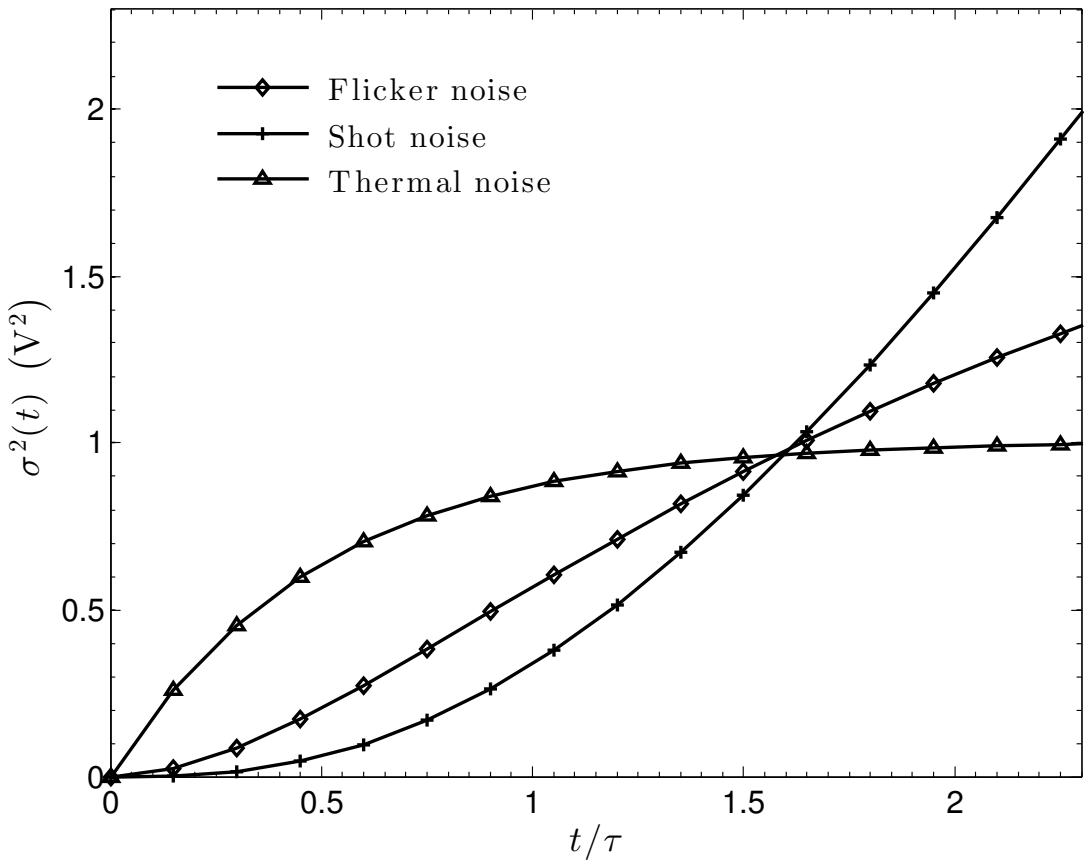
[picture p40: page 1]

Flicke r noise
Shot noise
T he rmal noise
