dlavila/puc_thesis/thesis/figures/example-eps-converted-to.pdf

2
th

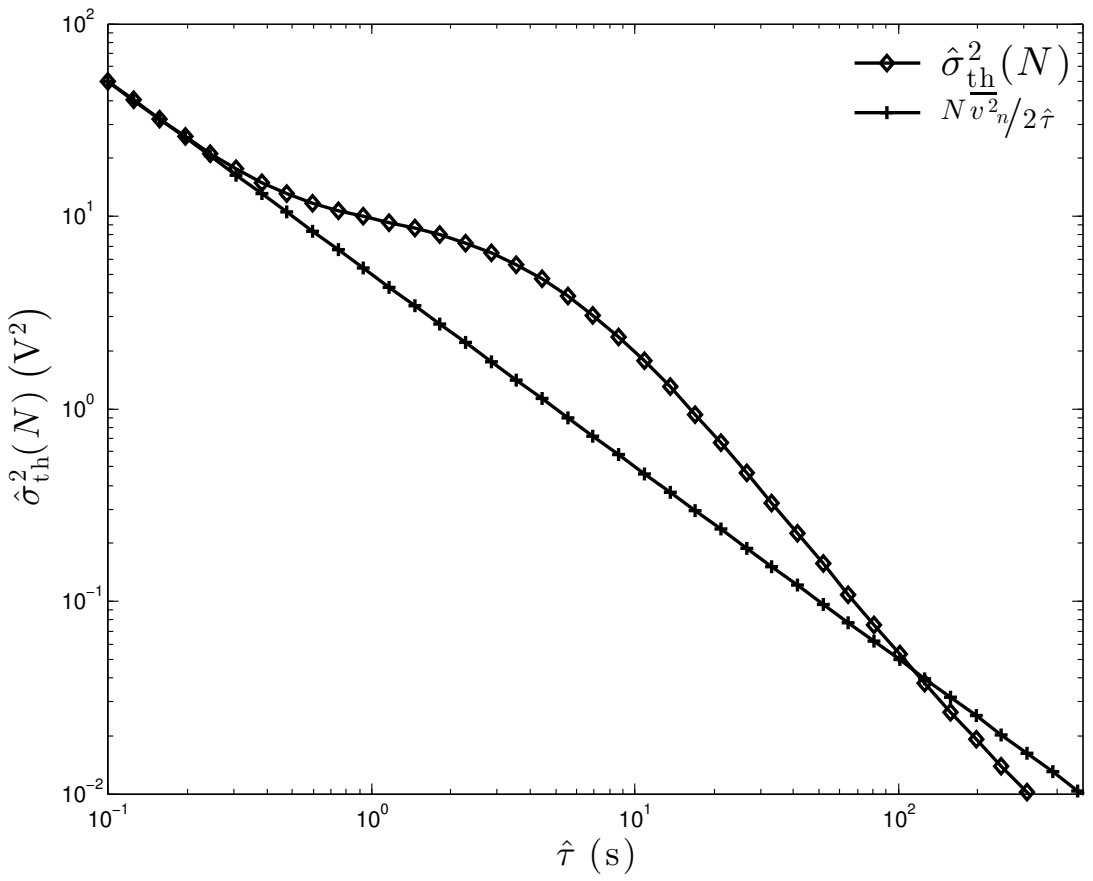
[picture p41: page 1]
