dlavila/puc_thesis/thesis/figures/front-end-eps-converted-to.pdf

## R CF

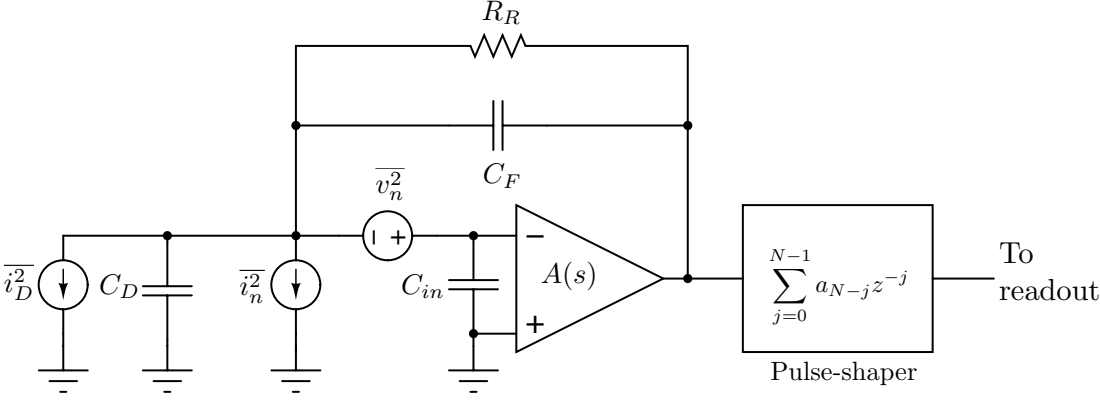
[picture p42: page 1]
Pulse-shaper; Cin; readout
