dlavila/puc_thesis/thesis/figures/optimum_wf-eps-converted-to.pdf

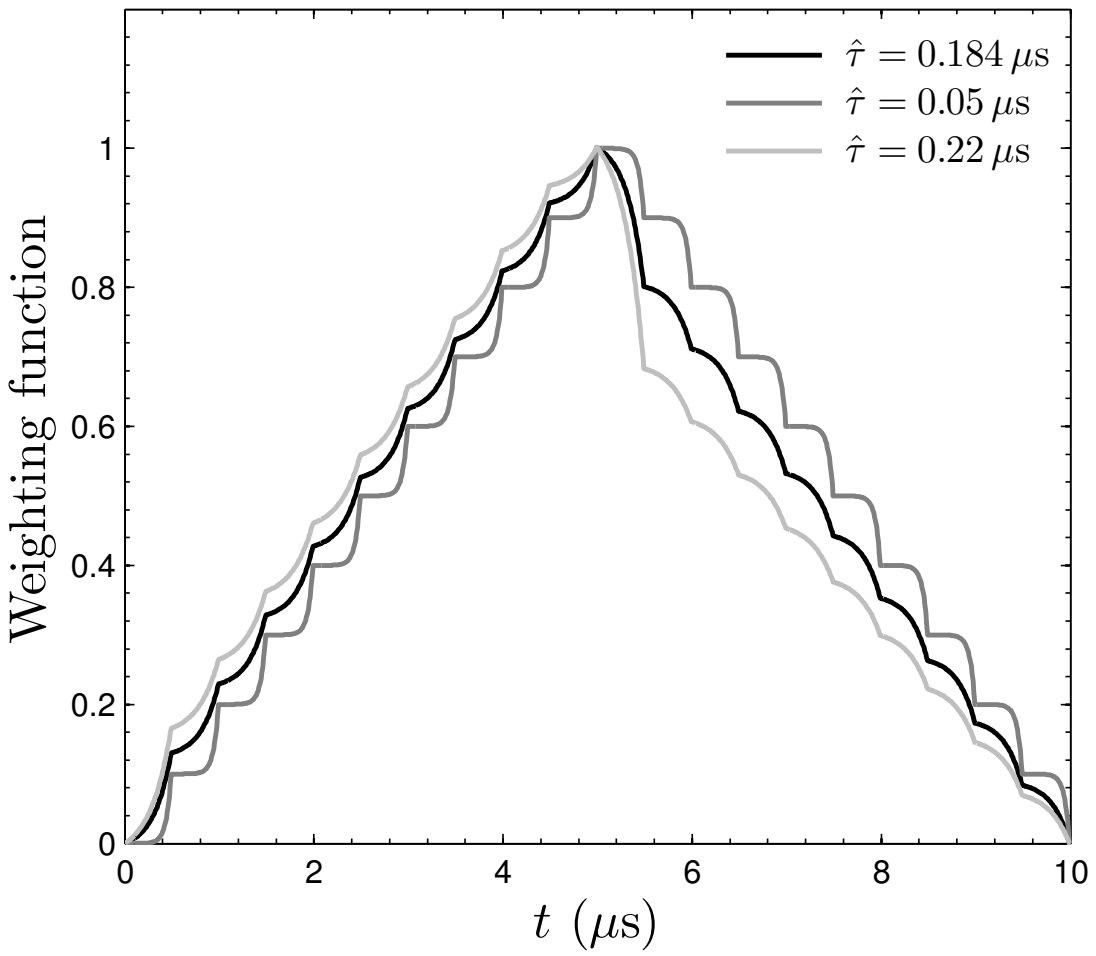
[picture p43: page 1]
Weighting function
