dlavila/puc_thesis/thesis/figures/sequence-eps-converted-to.pdf

Pi
! → σ

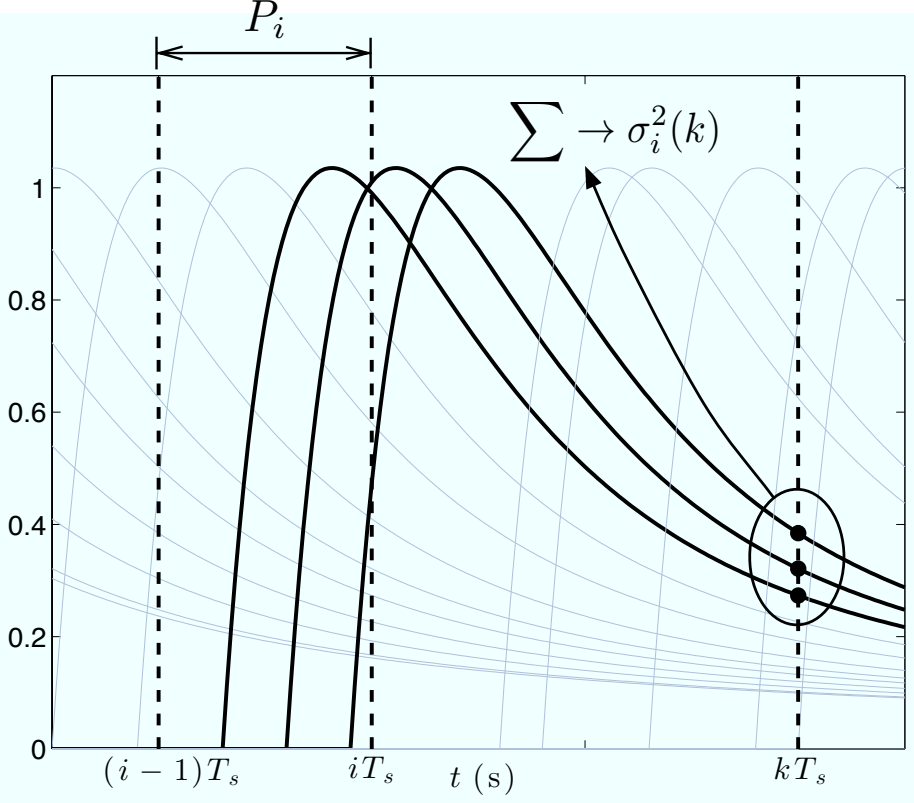
[picture p44: page 1]
iTs
