dlavila/puc_thesis/thesis/figures/system-eps-converted-to.pdf

# CSAyˆ

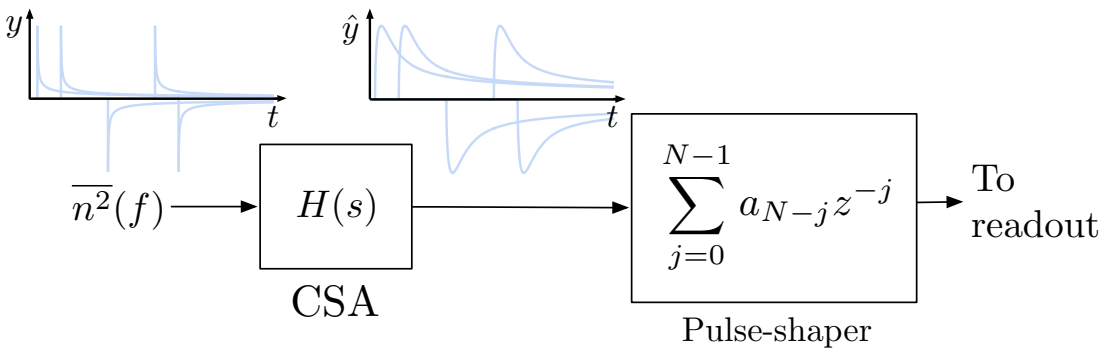
[picture p45: page 1]
Pulse-shaper; readout
