dlavila/puc_thesis/sc_ic/giggity.proj/RR_BUFFER.lib/default.group/logic.views/testBuffer/eldonet/testBuffer_eldonet.cir

* Component: $RR_BUFFER/default.group/logic.views/testBuffer  Viewpoint: eldonet
.INCLUDE $RR_BUFFER/default.group/logic.views/testBuffer/eldonet/testBuffer_eldonet.spi
.INCLUDE $MGC_DESIGN_KIT/models/ELDO/include_all
.PROBE VX




.OPTION NOASCII
.OPTION MODWL
.OPTION ENGNOT
.OPTION AEX

.TEMP 27 

.OPTION PROBOP2
.OPTION PROBOPX
.OP
.AC dec 10 1 10gig
