dlavila/puc_thesis/sc_ic/giggity.proj/SC_filter.lib/default.group/logic.views/testOTA/eldonet/testOTA_eldonet.cir

* Component: $SC_filter/default.group/logic.views/testOTA  Viewpoint: eldonet
.INCLUDE $SC_filter/default.group/logic.views/testOTA/eldonet/testOTA_eldonet.spi
.INCLUDE $MGC_DESIGN_KIT/models/ELDO/include_all
.PROBE VX




.OPTION NOASCII
.OPTION MODWL
.OPTION ENGNOT
.OPTION AEX

.TEMP 27 

.AC dec 10 1 10gig
