dlavila/puc_thesis/sc_ic/giggity.proj/SC_filter.lib/default.group/logic.views/CHANNEL/eldonet/CHANNEL_eldonet.cir

* Component: $SC_filter/default.group/logic.views/CHANNEL  Viewpoint: eldonet
.INCLUDE $SC_filter/default.group/logic.views/CHANNEL/eldonet/CHANNEL_eldonet.spi
.INCLUDE $MGC_DESIGN_KIT/models/ELDO/include_all
.PROBE VX
.PROBE VX




.OPTION NOASCII
.OPTION MODWL
.OPTION ENGNOT
.OPTION AEX

.TEMP 27 

.OPTION PROBOP2
.OPTION PROBOPX
.OP
.TRAN  0 1200n 0 100p
