dlavila/puc_thesis/sc_ic/giggity.proj/SC_filter.lib/default.group/logic.views/FILTER/eldonet/FILTER_eldonet.cir

* Component: $SC_filter/default.group/logic.views/FILTER  Viewpoint: eldonet
.INCLUDE $SC_filter/default.group/logic.views/FILTER/eldonet/FILTER_eldonet.spi
.INCLUDE $MGC_DESIGN_KIT/models/ELDO/include_all
.PROBE VX




.OPTION NOASCII
.OPTION MODWL
.OPTION ENGNOT
.OPTION AEX

.TEMP 27 

.TRAN  0 1500N 0 100p
