dlavila/puc_thesis/sc_ic/giggity.proj/SC_filter.lib/default.group/layout.views/BUFFER/BUFFER.cal/svdb/BUFFER.sp

* SPICE NETLIST
***************************************

.SUBCKT L POS NEG SUB
.ENDS
***************************************
.SUBCKT BUFFER Vpcas Vb2 Vi+ Vi- Vb3 Vncas Vb1 Vb4 AVdd AGnd Vo
** N=63 EP=11 IP=0 FDC=244
C0 39 Vo L=1.3e-05 W=6.5e-06 $[MIMCAPS_MM] $X=12360 $Y=16440 $D=64
C1 38 Vo L=1.3e-05 W=6.5e-06 $[MIMCAPS_MM] $X=12360 $Y=24990 $D=64
C2 39 Vo L=1.3e-05 W=6.5e-06 $[MIMCAPS_MM] $X=12360 $Y=33540 $D=64
C3 39 Vo L=1.3e-05 W=6.5e-06 $[MIMCAPS_MM] $X=12360 $Y=42090 $D=64
C4 38 Vo L=1.3e-05 W=6.5e-06 $[MIMCAPS_MM] $X=12360 $Y=50640 $D=64
C5 39 Vo L=1.3e-05 W=6.5e-06 $[MIMCAPS_MM] $X=12360 $Y=59190 $D=64
C6 38 Vo L=1.3e-05 W=6.5e-06 $[MIMCAPS_MM] $X=101340 $Y=16550 $D=64
C7 39 Vo L=1.3e-05 W=6.5e-06 $[MIMCAPS_MM] $X=101340 $Y=25100 $D=64
C8 38 Vo L=1.3e-05 W=6.5e-06 $[MIMCAPS_MM] $X=101340 $Y=33650 $D=64
C9 38 Vo L=1.3e-05 W=6.5e-06 $[MIMCAPS_MM] $X=101340 $Y=42200 $D=64
C10 39 Vo L=1.3e-05 W=6.5e-06 $[MIMCAPS_MM] $X=101340 $Y=50750 $D=64
C11 38 Vo L=1.3e-05 W=6.5e-06 $[MIMCAPS_MM] $X=101340 $Y=59300 $D=64
R12 38 1 wr=2e-06 lr=1e-05 $SUB=AVdd $[RNHR1000_MM] $X=33090 $Y=24010 $D=45
R13 5 39 wr=2e-06 lr=1e-05 $SUB=AVdd $[RNHR1000_MM] $X=33090 $Y=39690 $D=45
R14 39 5 wr=2e-06 lr=1e-05 $SUB=AVdd $[RNHR1000_MM] $X=91510 $Y=24120 $D=45
R15 1 38 wr=2e-06 lr=1e-05 $SUB=AVdd $[RNHR1000_MM] $X=91510 $Y=39800 $D=45
M16 Vo 1 AVdd AVdd P_18_MM L=4.5e-07 W=2.5e-06 AD=6.75e-13 AS=1.225e-12 PD=5.4e-07 PS=3.48e-06 $X=31930 $Y=74480 $D=3
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
M242 AGnd 5 Vo AGnd N_18_MM L=4.5e-07 W=1.6e-06 AD=7.84e-13 AS=4.32e-13 PD=2.58e-06 PS=5.4e-07 $X=83720 $Y=11160 $D=2
M243 AGnd 5 Vo AGnd N_18_MM L=4.5e-07 W=1.6e-06 AD=7.84e-13 AS=4.32e-13 PD=2.58e-06 PS=5.4e-07 $X=83720 $Y=13640 $D=2
.ENDS
***************************************
