dlavila/puc_thesis/(commit log)

2013-08-06 added switch sim script
2013-08-06 added switch data for nmos device
2013-08-06 Added switch data for pmos devices
2013-09-04 added switched capacitor OTA optimization matlab script. Also, small changes in the switch curves script
2013-09-23 minor changes, trying to lear to add properties to a schematic
2013-09-27 done switch curves, missing comments and documentation
2013-09-30 added new filter solutions
2013-10-10 added the first version of the filter OTA
2014-01-04 se agregaron la mayoria de los esquematicos del proyecto
2014-02-09 finished OTA, OTA_CMFB, Filter layout
    [BUFFER.stl, BUFFER_2.stl]
2014-04-10 se agrego la tesis al repositorio
2014-05-22 actualizacion de tesis: falta poco
    [test_gains_step_response.csv]
